suisanka/Project_Pulsar/exports/2026-10-24-reference-fit/README.zh-CN.md

# 已弃用：ReferenceFit 扩展试验

用户已明确要求原样采用提供的后壳，不按头模测试修改后壳。本目录中后移 40 mm 的旧七件套仅保留作历史记录，不作为当前方案。

当前数据与交付文件见 [后壳原样采用说明](../../docs/REFERENCE_REAR_EXACT.zh-CN.md)。
