suisanka/Project_Pulsar/variants/reference-fit/README.zh-CN.md

# 已弃用：ReferenceFit 扩展试验

`ProjectPulsar_ReferenceFit.blend` 保留为历史文件，不作为当前后壳方案。当前直接采用用户原始 STL，见 [后壳原样采用说明](../../docs/REFERENCE_REAR_EXACT.zh-CN.md)。
