suisanka/Project_Pulsar/docs/images/closure-v3-overview.png

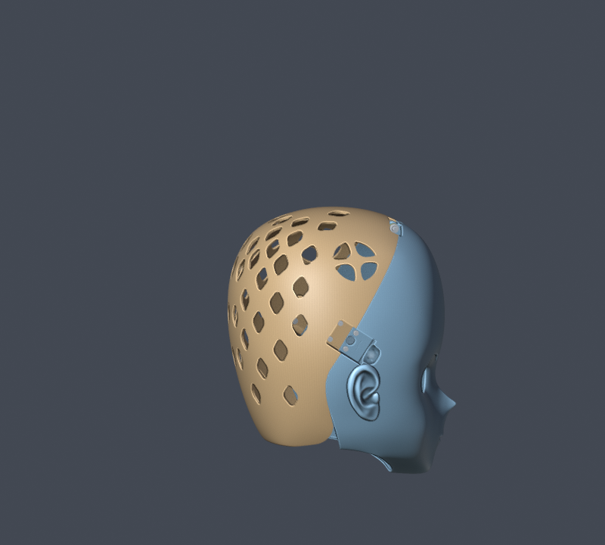
docs/images/closure-v3-overview.png
