suisanka/Project_Pulsar/docs/images/front-3mm-review_face.png

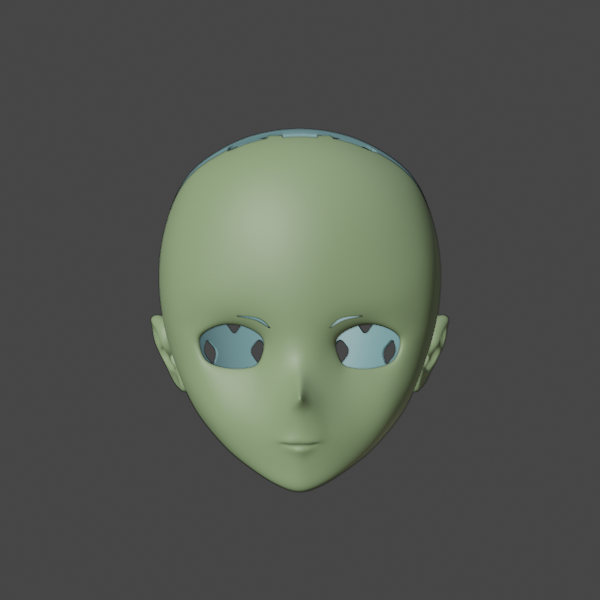
docs/images/front-3mm-review_face.png
