suisanka/Project_Pulsar/docs/images/front-3mm-review_face_quarter.png

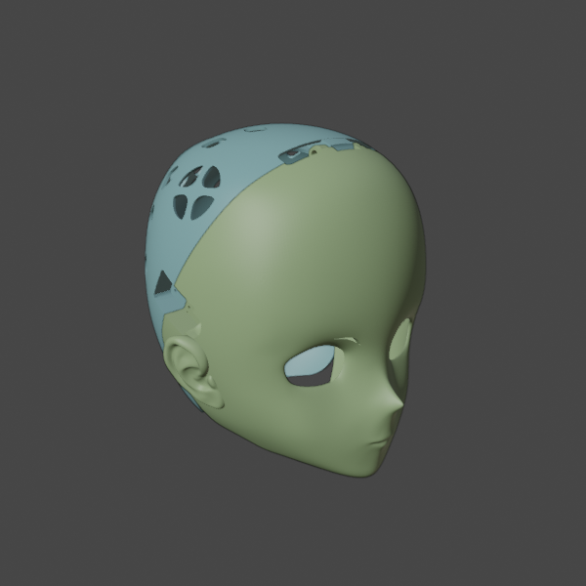
docs/images/front-3mm-review_face_quarter.png
