suisanka/Project_Pulsar/docs/images/front-3mm-review_right.png

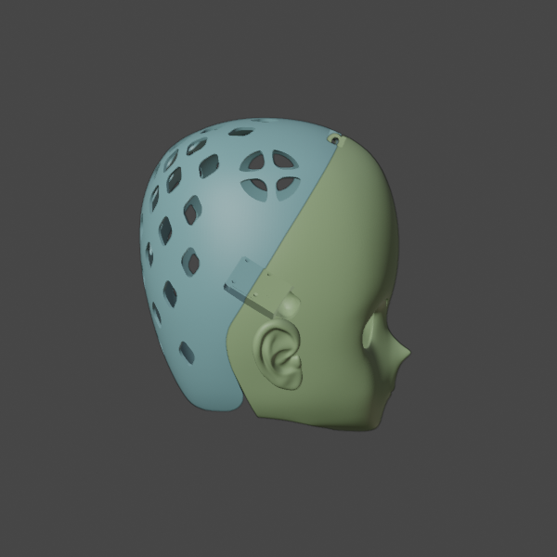
docs/images/front-3mm-review_right.png
