suisanka/Project_Pulsar/docs/images/front-3mm-review_top.png

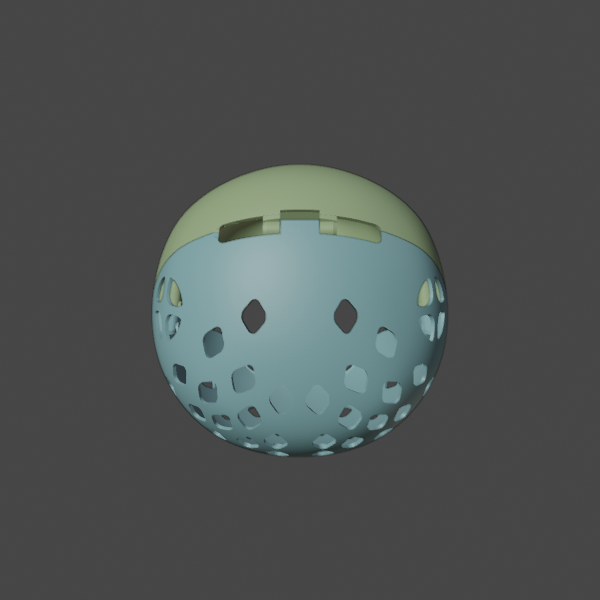
docs/images/front-3mm-review_top.png
