suisanka/Project_Pulsar/docs/images/front-3mm-wire.png

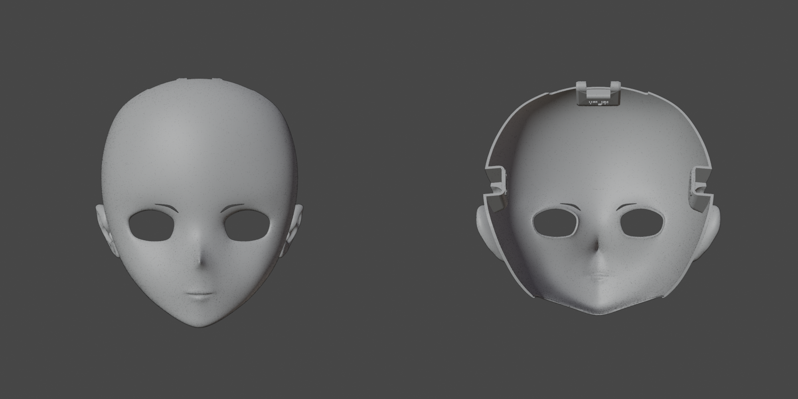
docs/images/front-3mm-wire.png
