suisanka/Project_Pulsar/docs/images/front-3mm-wire_inside.png

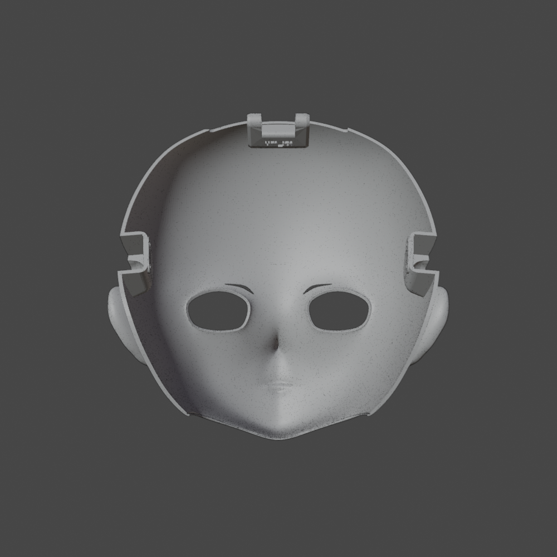
docs/images/front-3mm-wire_inside.png
