suisanka/Project_Pulsar/docs/images/head-horizontal-section.png

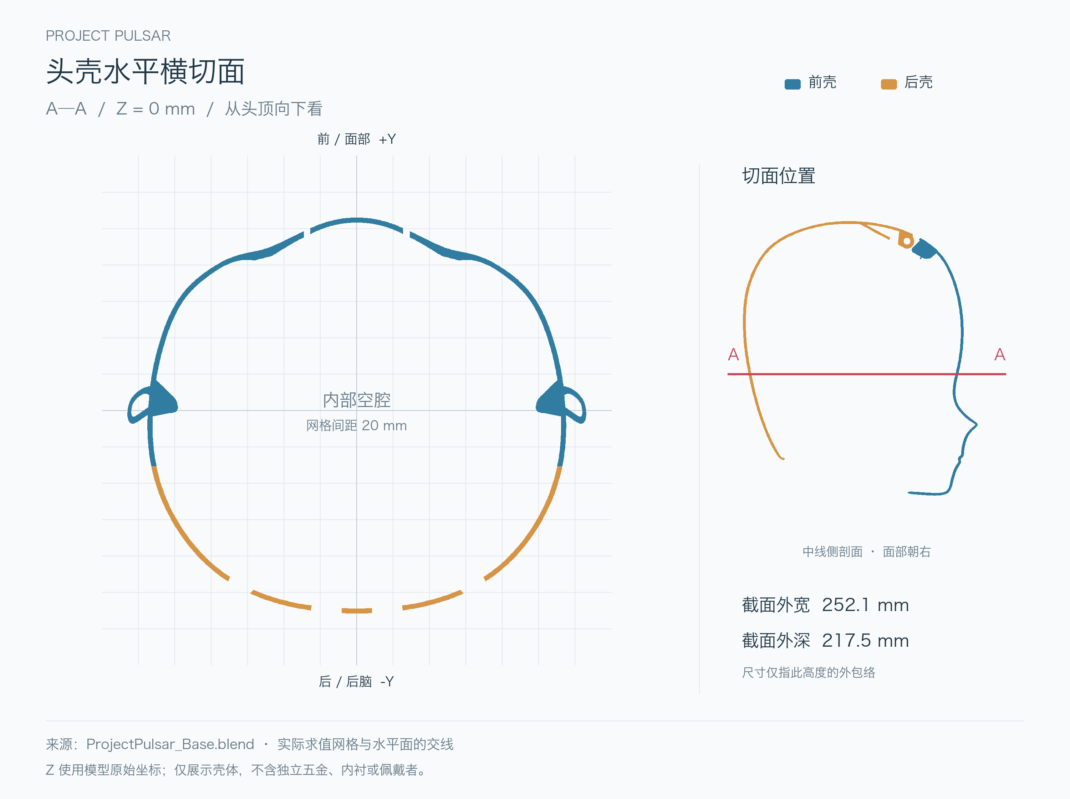
docs/images/head-horizontal-section.png
