suisanka/Project_Pulsar/docs/images/head-horizontal-sections-comparison.png

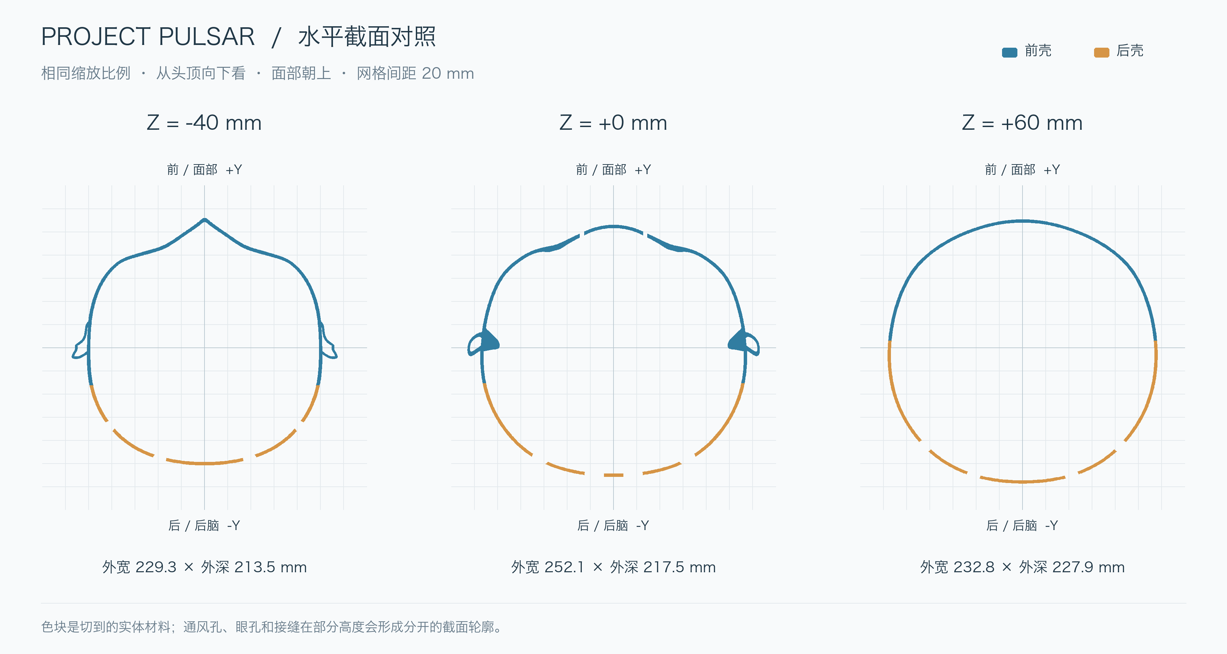
docs/images/head-horizontal-sections-comparison.png
