suisanka/Project_Pulsar/docs/images/head-vertical-section-dimensioned.png

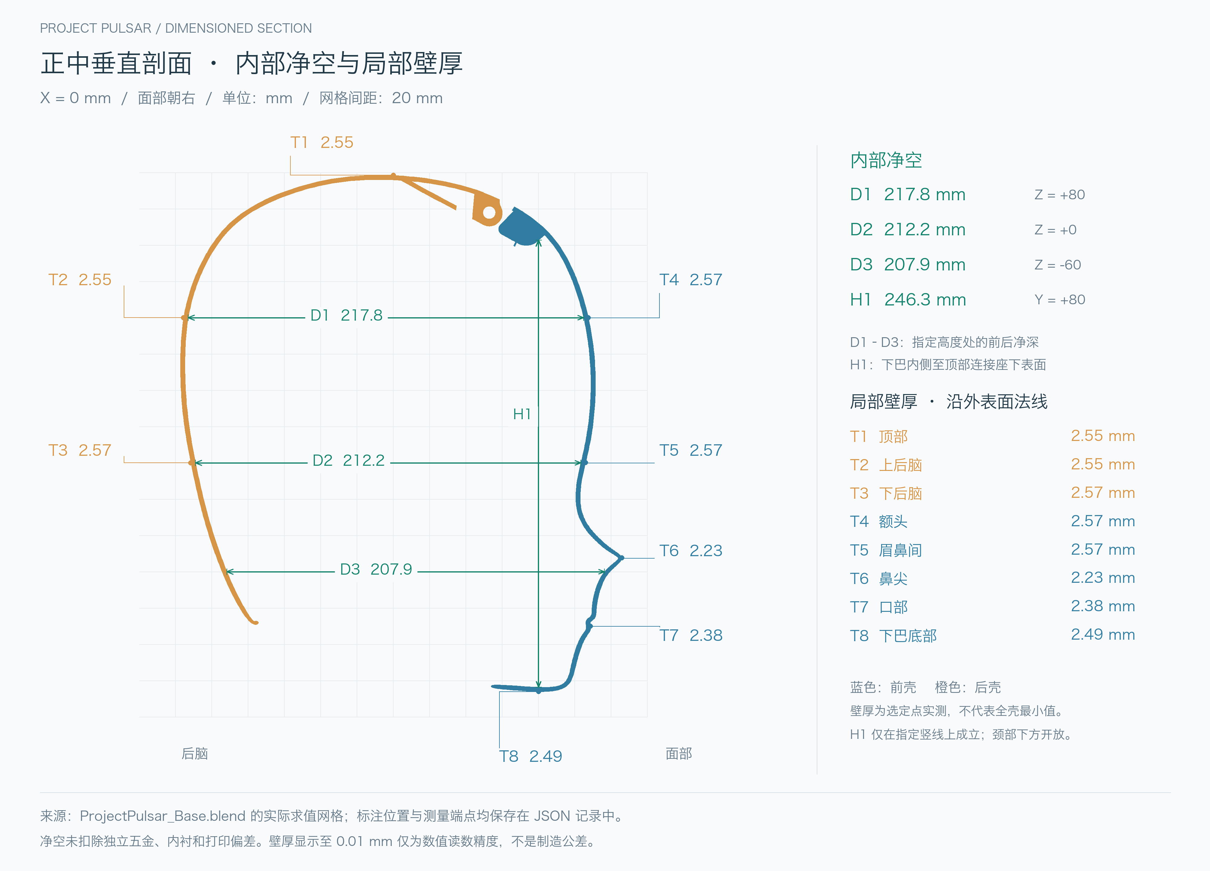
docs/images/head-vertical-section-dimensioned.png
