suisanka/Project_Pulsar/docs/images/head-vertical-section.png

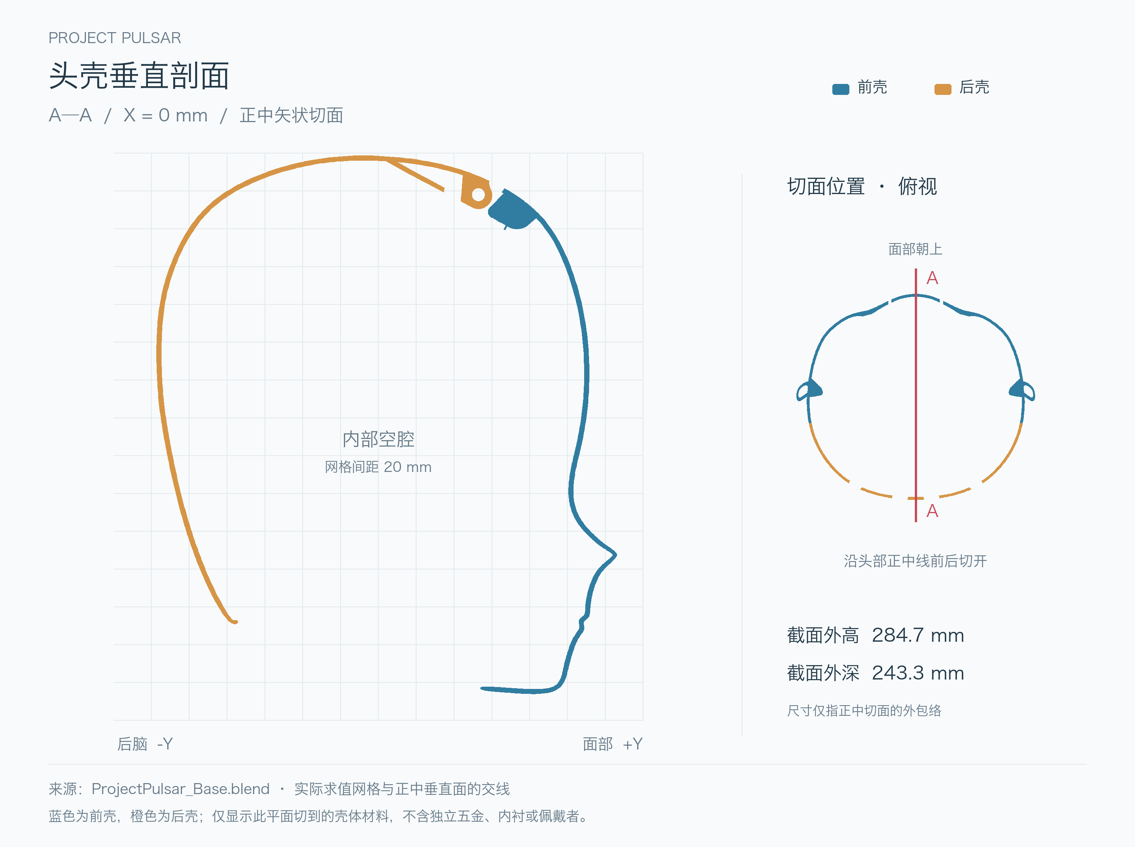
docs/images/head-vertical-section.png
