suisanka/Project_Pulsar/docs/images/headform-ellipse-cutaway.png

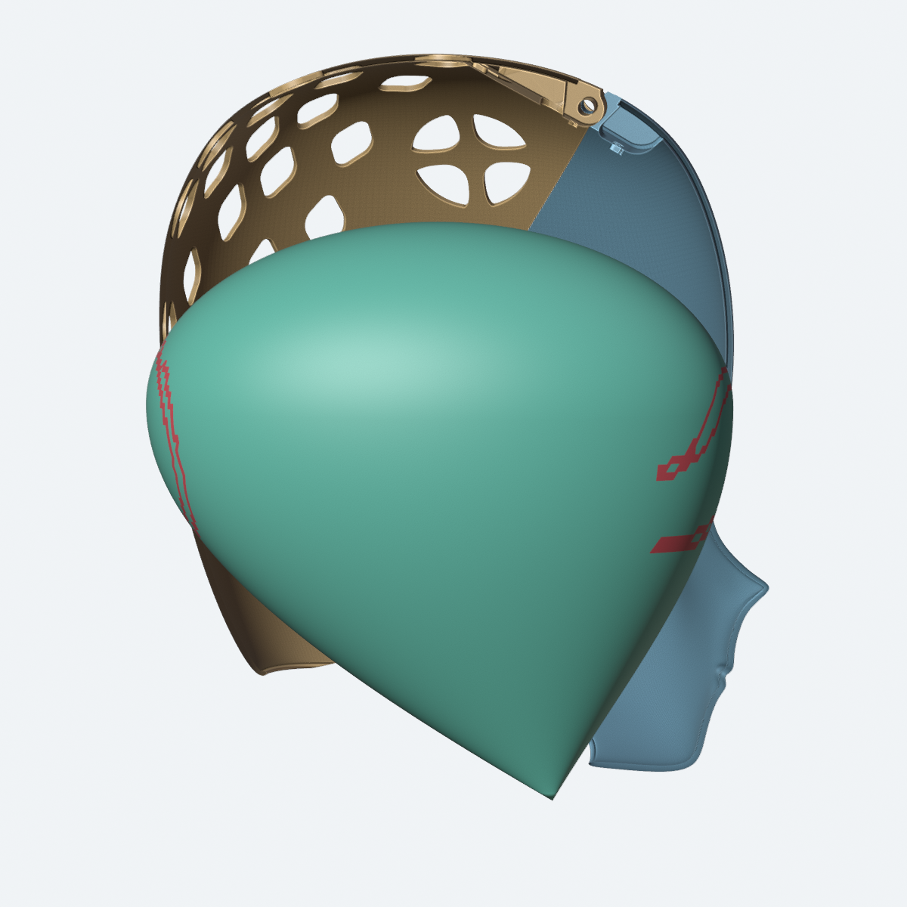
docs/images/headform-ellipse-cutaway.png
