suisanka/Project_Pulsar/docs/images/headform-ellipse-topology.png

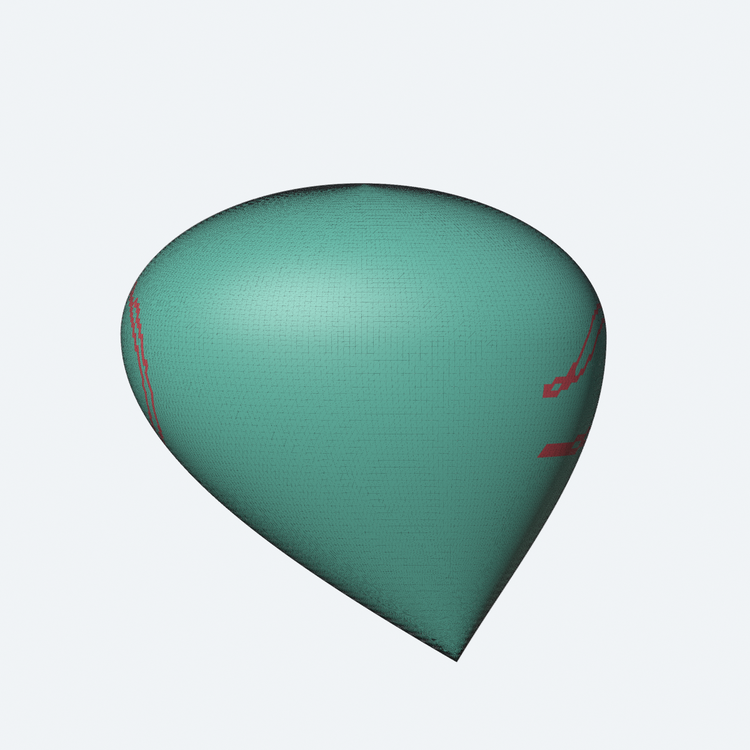
docs/images/headform-ellipse-topology.png
