suisanka/Project_Pulsar/docs/images/headform-fit-comparison.png

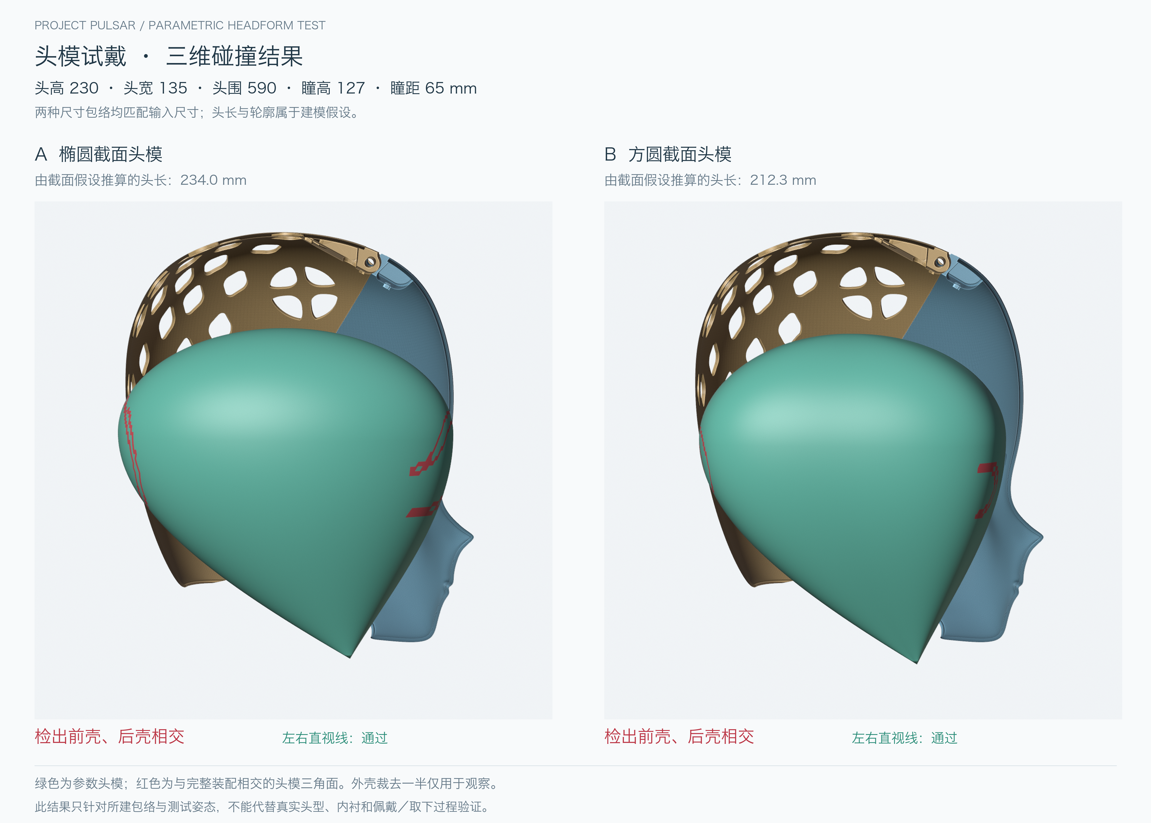
docs/images/headform-fit-comparison.png
