suisanka/Project_Pulsar/docs/images/headform-fit-sections.png

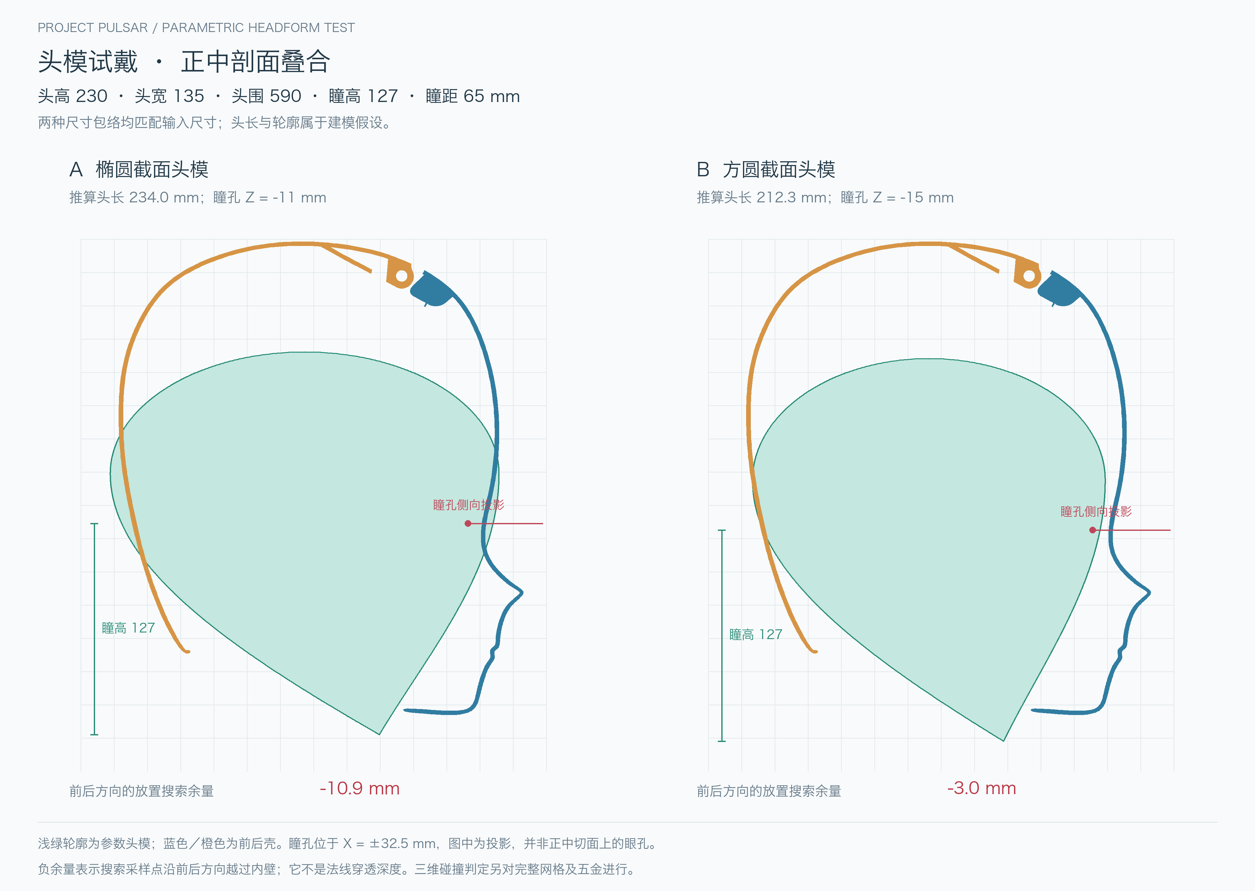
docs/images/headform-fit-sections.png
