suisanka/Project_Pulsar/docs/images/headform-rounded-topology.png

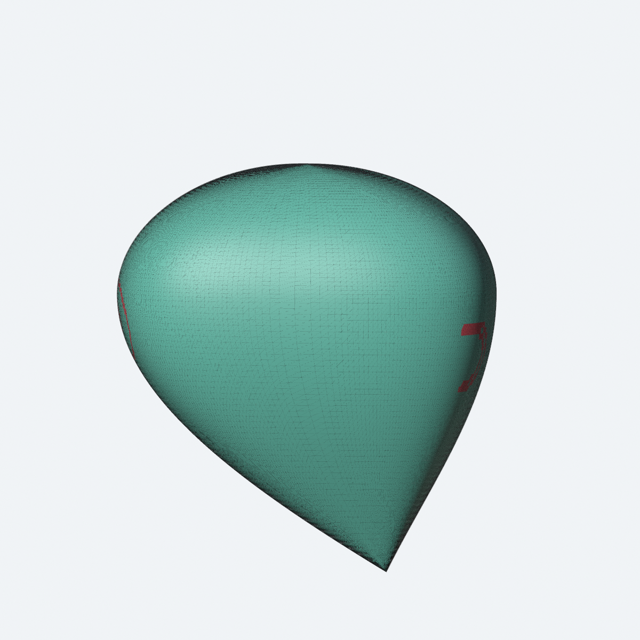
docs/images/headform-rounded-topology.png
