suisanka/Project_Pulsar/docs/images/hinge-v2-closed.png

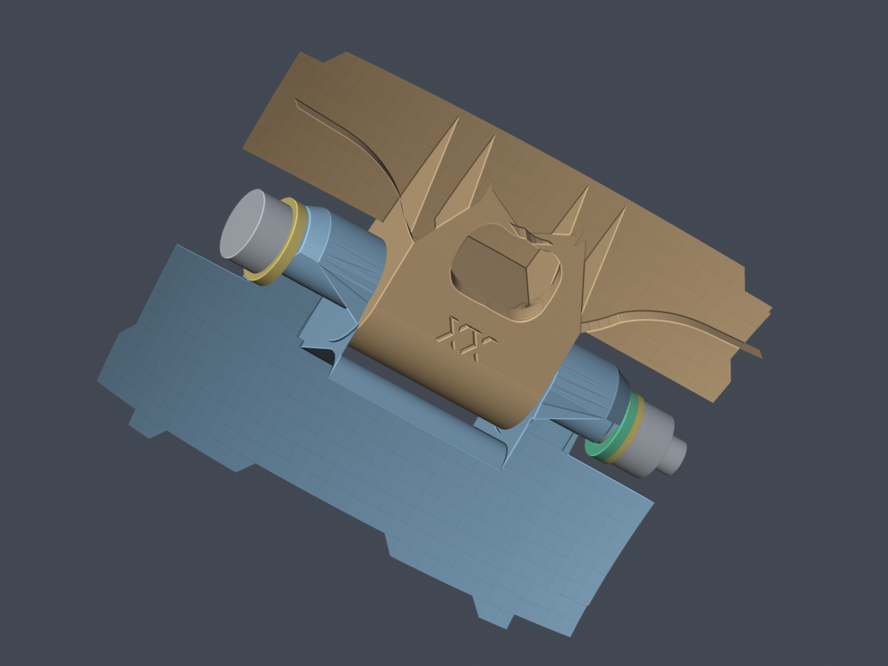
docs/images/hinge-v2-closed.png
