suisanka/Project_Pulsar/docs/images/hinge-v2-open-75.png

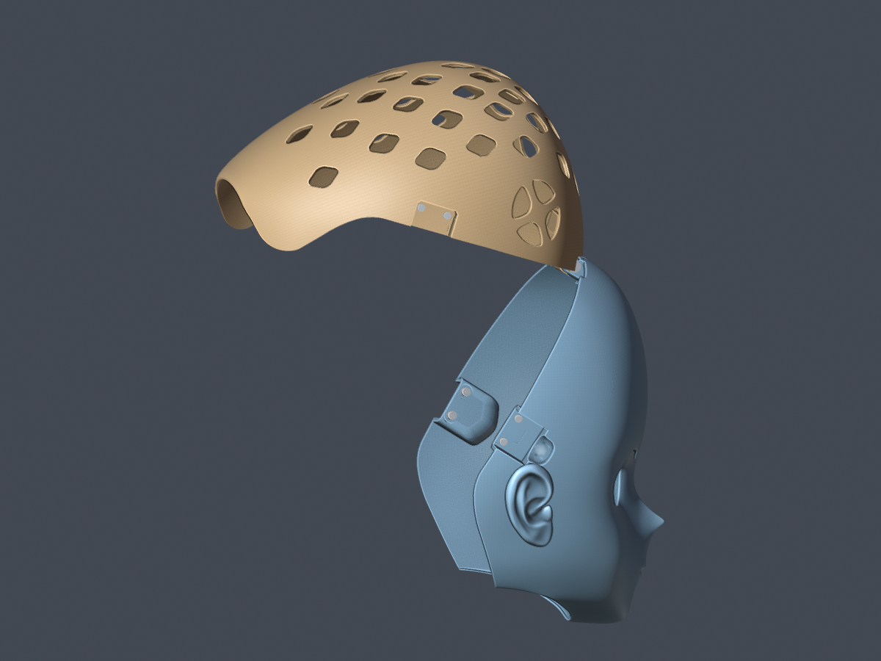
docs/images/hinge-v2-open-75.png
