suisanka/Project_Pulsar/docs/images/overview.png

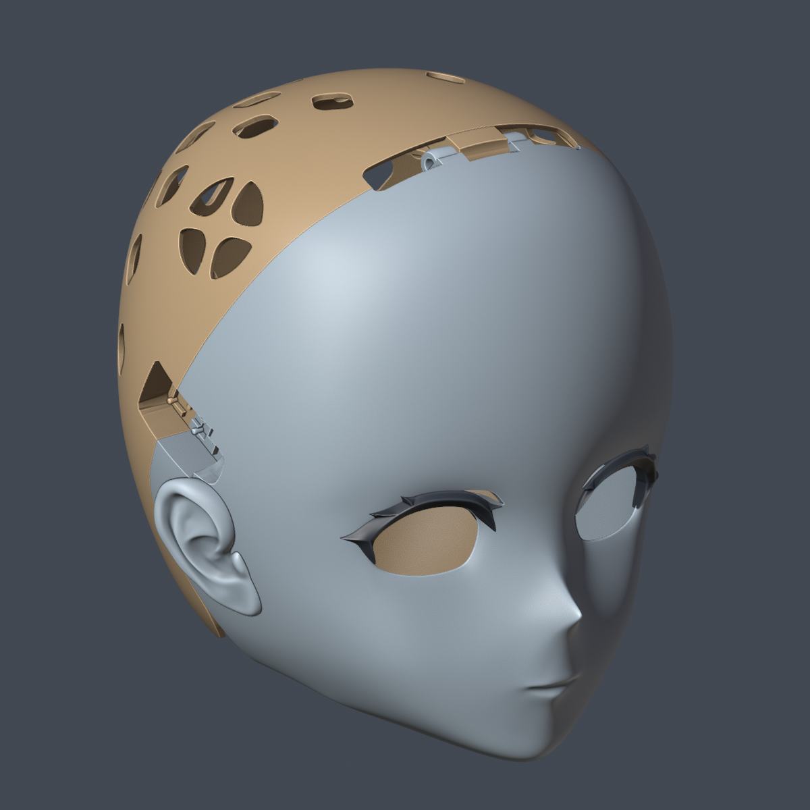
docs/images/overview.png
