suisanka/Project_Pulsar/docs/images/r-pin-profile.png

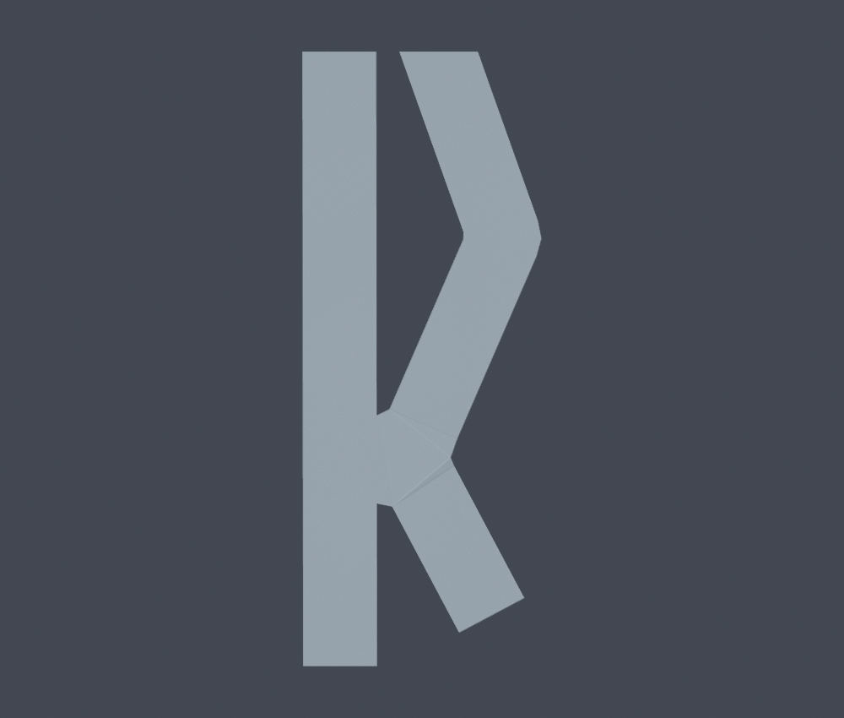
docs/images/r-pin-profile.png
