suisanka/Project_Pulsar/docs/images/reference-fit/ref-front-inside.png

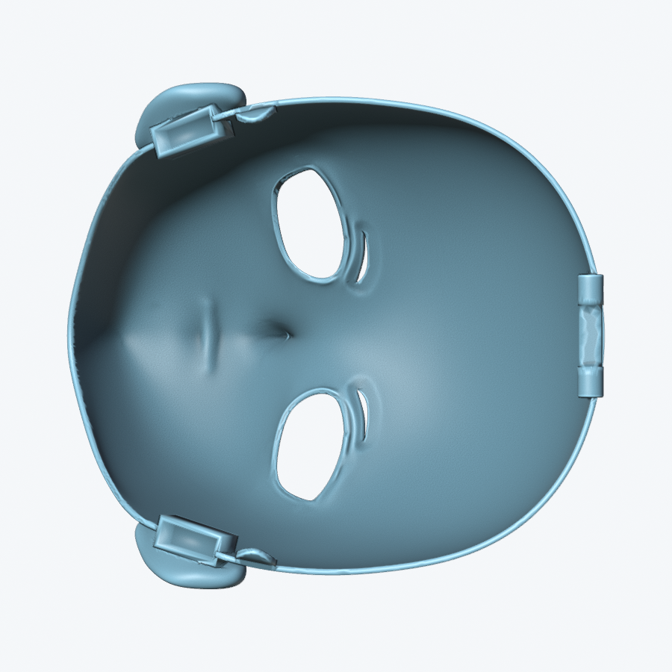
docs/images/reference-fit/ref-front-inside.png
