suisanka/Project_Pulsar/docs/images/reference-fit/ref-front-outside.png

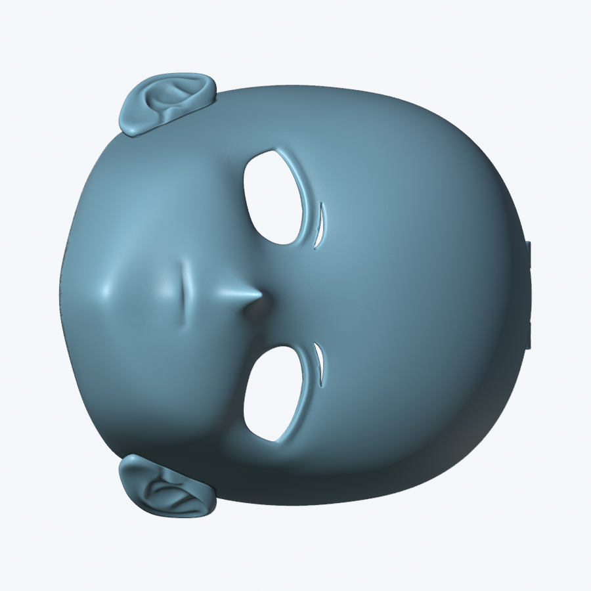
docs/images/reference-fit/ref-front-outside.png
