suisanka/Project_Pulsar/docs/images/reference-fit/ref-rear-inside.png

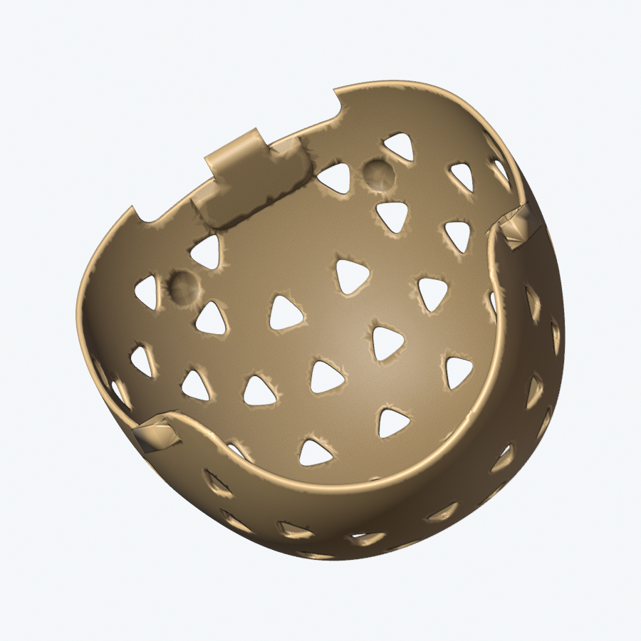
docs/images/reference-fit/ref-rear-inside.png
