suisanka/Project_Pulsar/docs/images/reference-fit/ref-rear-outside.png

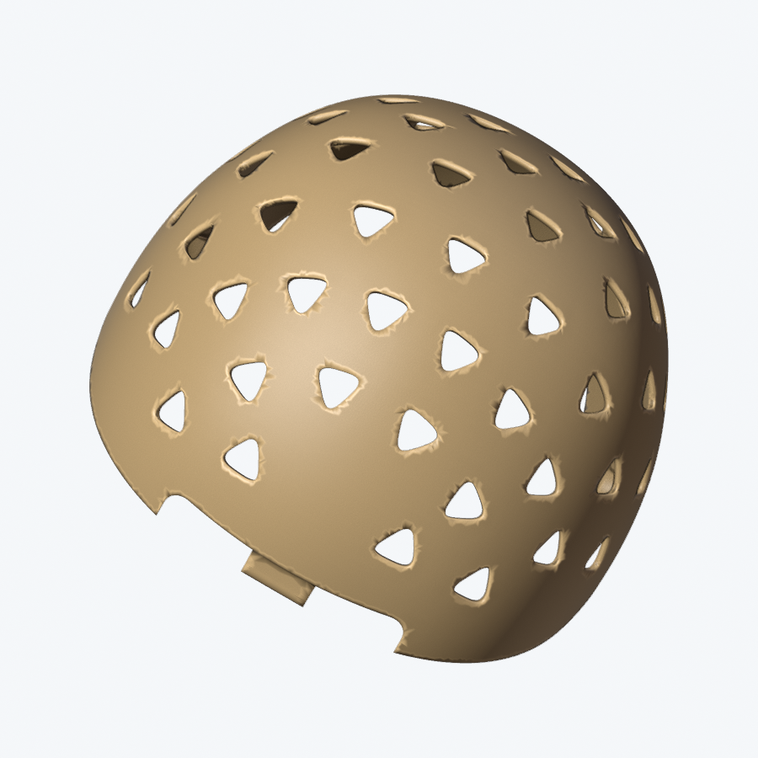
docs/images/reference-fit/ref-rear-outside.png
