suisanka/Project_Pulsar/docs/images/reference-fit/reference-fit-after-back.png

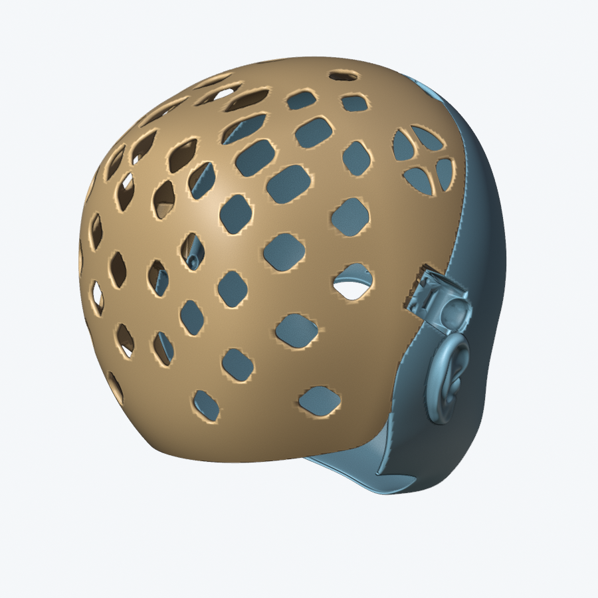
docs/images/reference-fit/reference-fit-after-back.png
