suisanka/Project_Pulsar/docs/images/reference-fit/reference-fit-after-cutaway.png

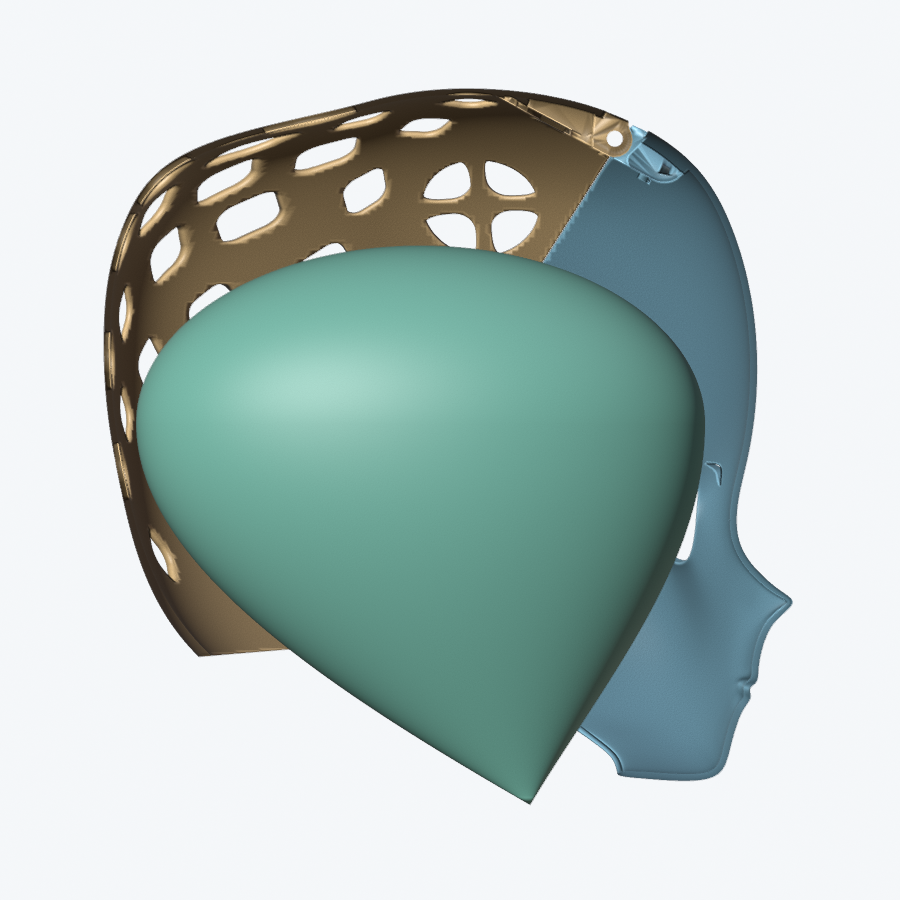
docs/images/reference-fit/reference-fit-after-cutaway.png
