suisanka/Project_Pulsar/docs/images/reference-fit/reference-fit-after-quarter.png

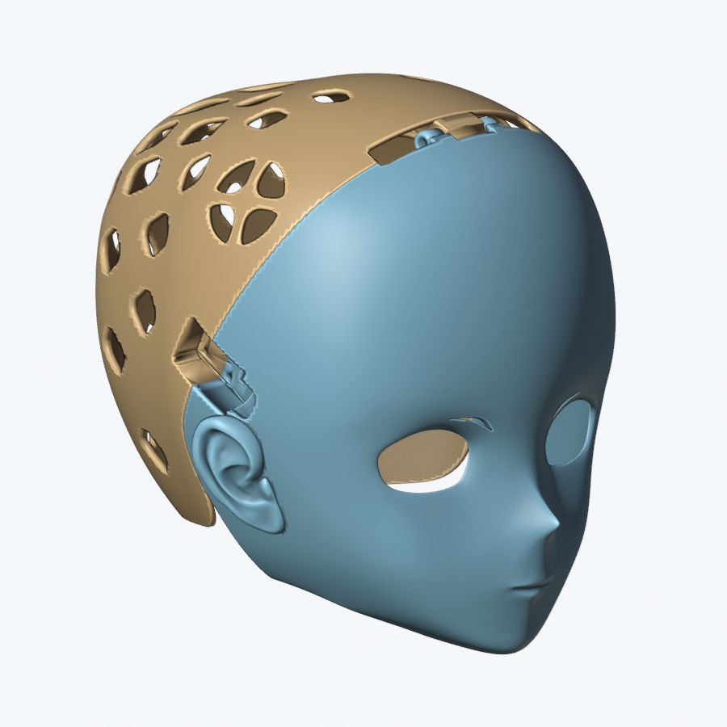
docs/images/reference-fit/reference-fit-after-quarter.png
