suisanka/Project_Pulsar/docs/images/reference-fit/reference-fit-after-side.png

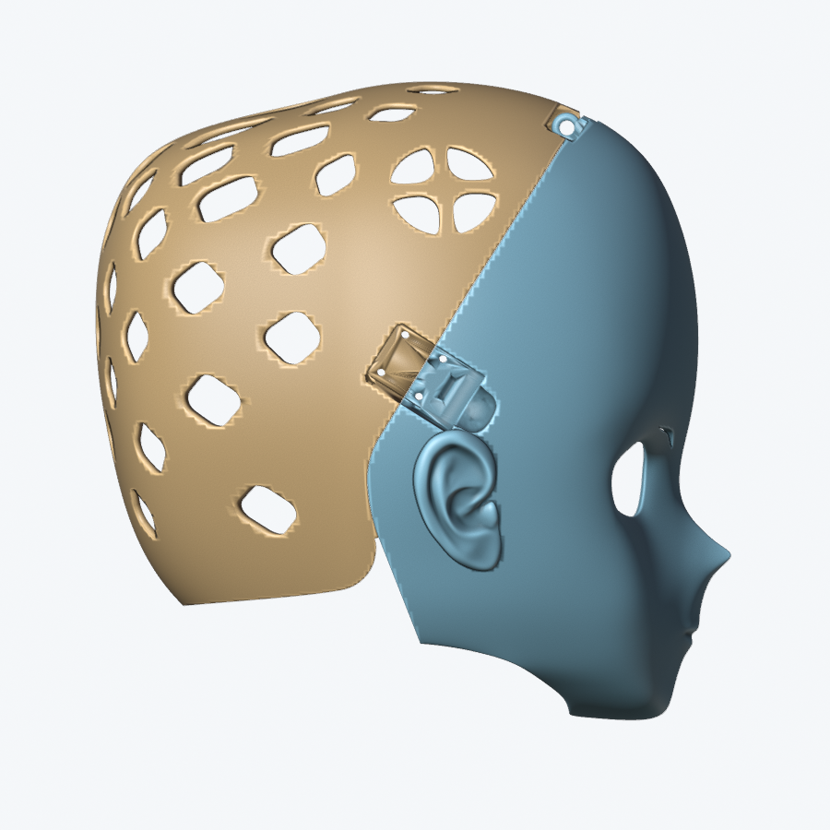
docs/images/reference-fit/reference-fit-after-side.png
