suisanka/Project_Pulsar/docs/images/reference-fit/reference-fit-before-side.png

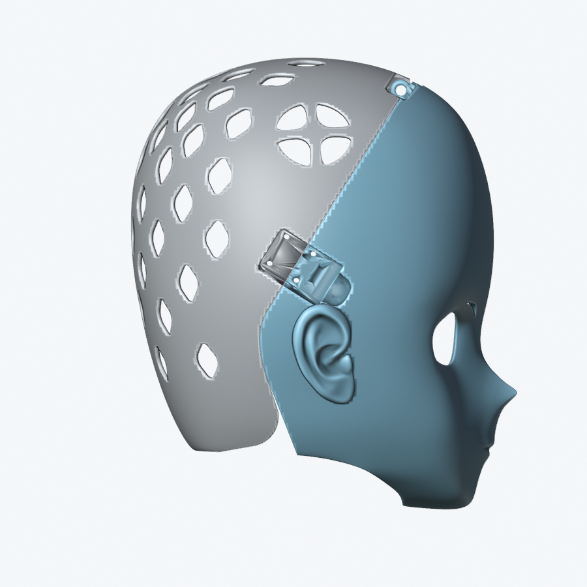
docs/images/reference-fit/reference-fit-before-side.png
