suisanka/Project_Pulsar/docs/images/reference-fit/reference-fit-rear-wire-inside.png

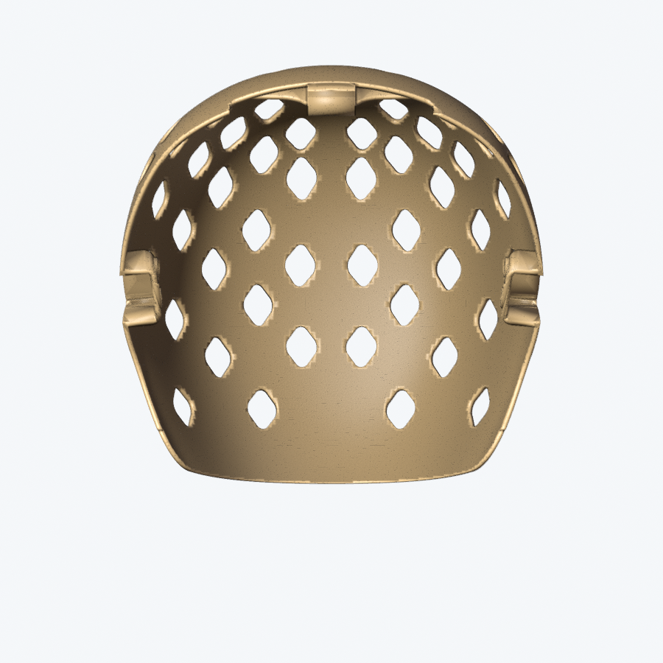
docs/images/reference-fit/reference-fit-rear-wire-inside.png
