suisanka/Project_Pulsar/docs/images/reference-fit/reference-fit-rear-wire.png

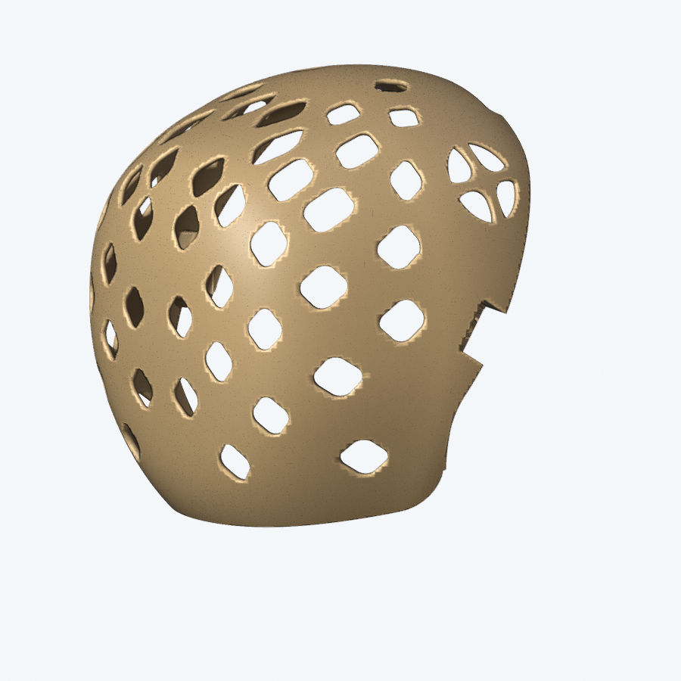
docs/images/reference-fit/reference-fit-rear-wire.png
