suisanka/Project_Pulsar/docs/images/reference-rear-exact/rear-exact-inside.png

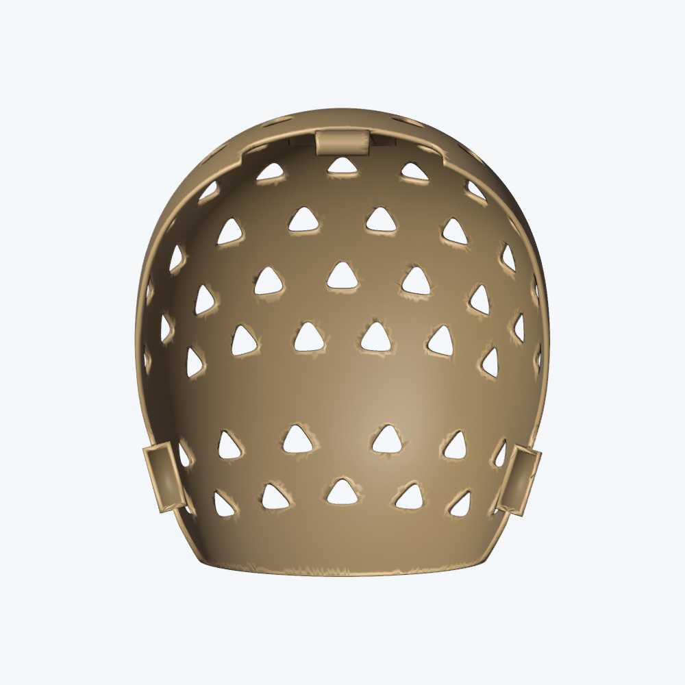
docs/images/reference-rear-exact/rear-exact-inside.png
