suisanka/Project_Pulsar/docs/images/reference-rear-rounded/rear-wire.png

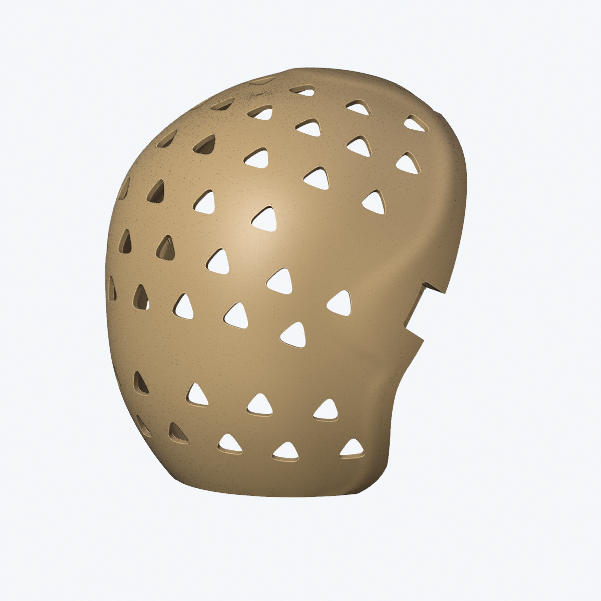
docs/images/reference-rear-rounded/rear-wire.png
