suisanka/Project_Pulsar/docs/images/side-latch-v3-inside.png

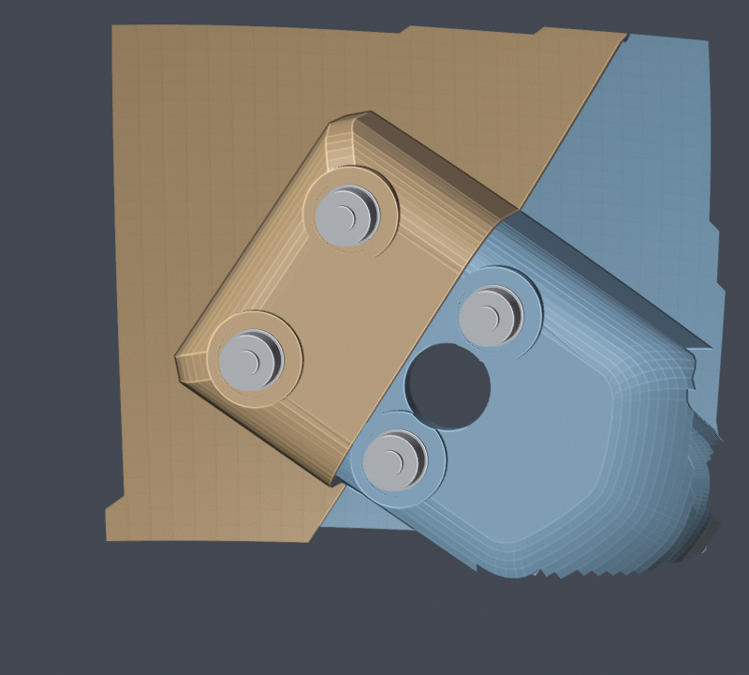
docs/images/side-latch-v3-inside.png
