suisanka/Project_Pulsar/docs/images/side-latch-v3-outside.png

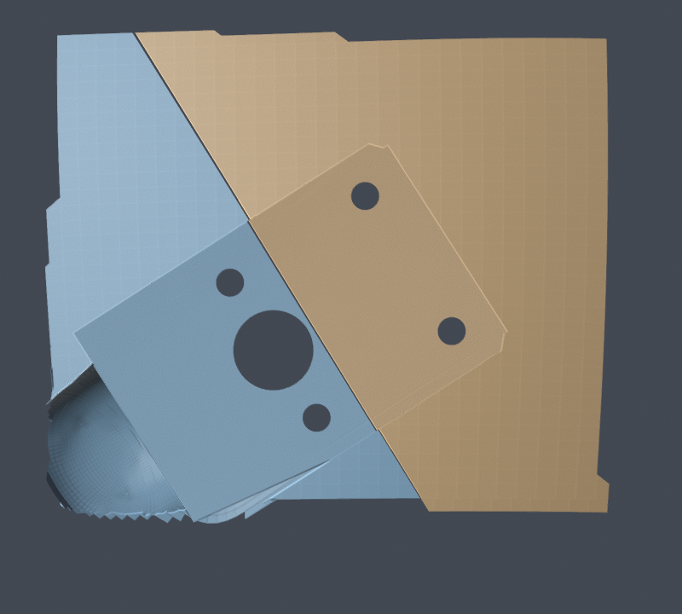
docs/images/side-latch-v3-outside.png
