suisanka/Project_Pulsar/docs/images/side-lock-dimensions.png

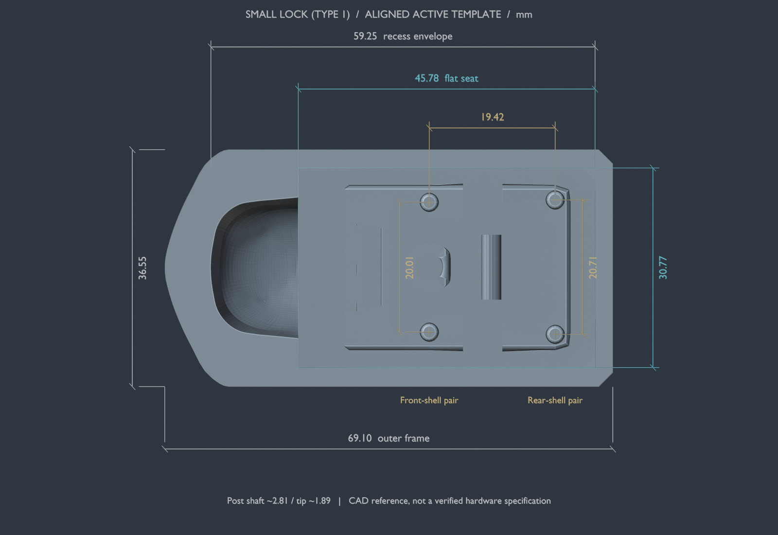
docs/images/side-lock-dimensions.png
