suisanka/Project_Pulsar/docs/images/side-lock-seat.png

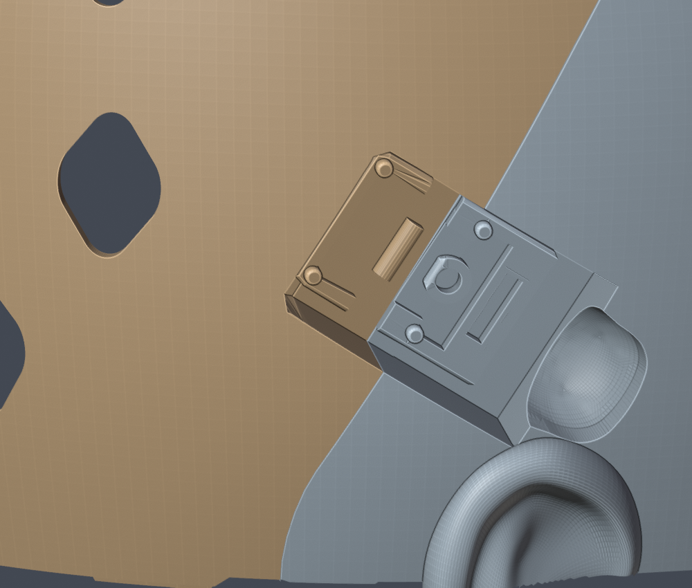
docs/images/side-lock-seat.png
