suisanka/Project_Pulsar/docs/images/top-hinge.png

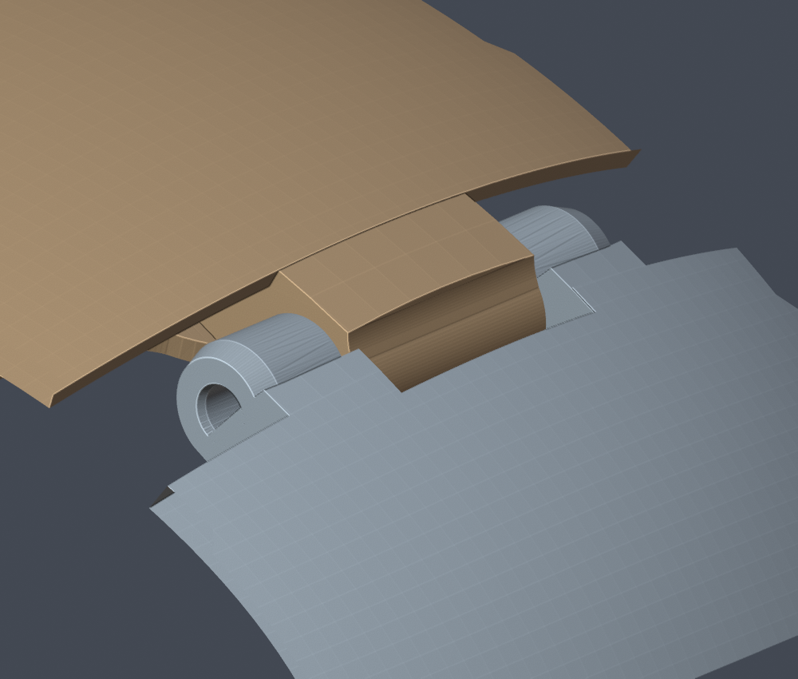
docs/images/top-hinge.png
