suisanka/Project_Pulsar/docs/ProjectPulsar_BOM_Closure_v4.csv

序号 | 类别 | 部位/用途 | 物料名称 | 规格（尺寸单位：mm） | 每套数量 | 单位 | 材料 | STL文件 | 备注
1 | 打印 | 壳体 | 前壳 | Closure v4；侧锁中心补实 | 1 | 件 | PLA | ProjectPulsar_Front_Closure_v4.stl | 拓竹 H2S，0.4 mm 喷嘴；耗材重量以切片为准
2 | 打印 | 壳体 | 后壳 | Closure v4 | 1 | 件 | PLA | ProjectPulsar_Rear_Closure_v4.stl | 拓竹 H2S，0.4 mm 喷嘴；与 v4 前壳配套
3 | 打印 | 顶部转轴 | 轴向垫套 | 内径 Ø6.6 × 外径 Ø10 × 厚 1.4 | 1 | 件 | PLA | ProjectPulsar_Hinge_Spacer_1p4.stl | 已平放；安装在螺母侧前壳耳面与 M5 平垫圈之间
4 | 采购 | 顶部转轴 | 金属肩轴螺钉 | 光轴 Ø6 × 55；尾牙 M5 × 0.8，长 9.5；头 Ø10 × 高 4.5 | 1 | 件 | 金属 |  | 尺寸实例 Ganter ISO 7379-6-M5-55；55 指光轴长度；明确选 Ø6，不选 Ø6.5
5 | 采购 | 顶部轴头侧 | M6 平垫圈 | 内径 6.4 × 外径 12 × 厚 1.6 | 1 | 件 | 金属 |  | 先套在肩轴上，置于轴头与前壳耳面之间
6 | 采购 | 顶部螺母侧 | M5 平垫圈 | 内径 5.3 × 外径 10 × 厚 1.0 | 1 | 件 | 金属 |  | 抵住 Ø6 金属轴肩；不要与轴头侧 M6 垫圈混用
7 | 采购 | 顶部螺母侧 | M5 尼龙圈防松螺母 | DIN 985；M5 × 0.8；对边 8，高 5 | 1 | 件 | 金属及尼龙圈 |  | 与 M5 平垫圈配合止退
8 | 采购 | 左右侧锁 | 带钥匙锁四方搭扣 | 40 × 27 × 12.5；孔距 20 × 20；4 孔 Ø3.5；底板厚 0.5 | 2 | 只 | 金属 |  | 每侧 1 只，含配对扣片；钥匙随锁配套；v4 中心无让位孔，先用试件确认实物贴合
9 | 采购 | 左右侧锁 | M3 低圆头螺丝 | ISO 7380-1；M3 × 10，螺距 0.5；头 Ø5.7 × 高 1.65 | 8 | 件 | 金属 |  | 每侧 4 件；选无额外法兰款；配 2 mm 内六角
10 | 采购 | 左右侧锁背面 | M3 平垫圈 | 内径 3.2 × 外径 7 × 厚 0.5 | 8 | 件 | 金属 |  | 每侧 4 件；置于塑料承压区与防松螺母之间
11 | 采购 | 左右侧锁背面 | M3 尼龙圈防松螺母 | DIN 985；M3 × 0.5；对边 5.5，高 4 | 8 | 件 | 金属及尼龙圈 |  | 每侧 4 件；名义装配后螺纹露出约 1 mm
12 | 试打 | 顶部铰链 | 前壳局部试件 | 与 v4 整壳相同配合几何 | 1 | 件 | PLA | ProjectPulsar_Hinge_Test_Front.stl | 先行装配试打；不计入成品壳体
13 | 试打 | 顶部铰链 | 后壳局部试件 | 与 v4 整壳相同配合几何 | 1 | 件 | PLA | ProjectPulsar_Hinge_Test_Rear.stl | 与顶部前壳试件配对
14 | 试打 | 左侧搭扣 | 前壳局部试件 | 20 × 20 孔距；中心无让位孔 | 1 | 件 | PLA | ProjectPulsar_SideLatch_Test_Front_L.stl | 使用 v4 导出目录中的文件；两侧孔型镜像相同
15 | 试打 | 左侧搭扣 | 后壳局部试件 | 20 × 20 孔距 | 1 | 件 | PLA | ProjectPulsar_SideLatch_Test_Rear_L.stl | 使用 v4 导出目录中的文件；与侧锁前壳试件配对
16 | 工具 | 顶部肩轴安装 | 内六角扳手 | 3 mm | 1 | 把 |  |  | 可重复使用，不装入成品
17 | 工具 | 侧锁螺丝安装 | 内六角扳手 | 2 mm | 1 | 把 |  |  | 可重复使用，不装入成品
18 | 工具 | 顶部螺母安装 | 小套筒 | 8 mm；外径 ≤12 mm | 1 | 个 |  |  | 可重复使用；匹配 M5 螺母
19 | 工具 | 侧锁螺母安装 | 薄壁套筒 | 5.5 mm；外径 ≤8 mm | 1 | 个 |  |  | 可重复使用；匹配 M3 螺母
