suisanka/Project_Pulsar/assets/reference/user-rear-2026-10-24/后半头壳-全头.stl

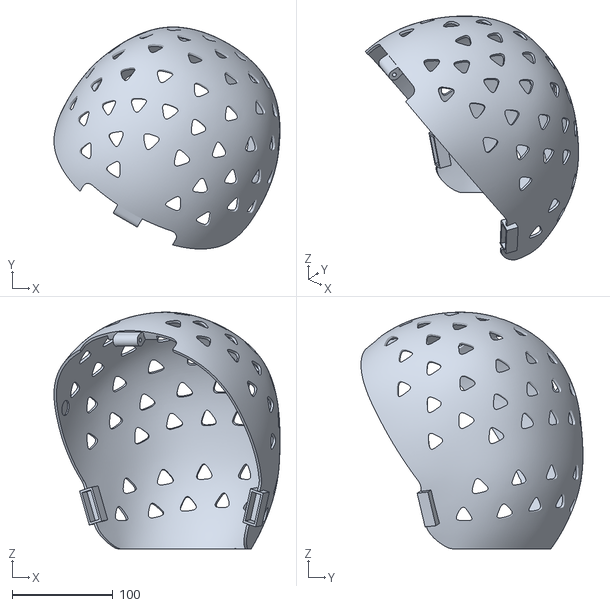
[picture p48: CAD file, 2026-10-24]
assets/reference/user-rear-2026-10-24/后半头壳-全头.stl
224.3 x 220.3 x 234.9
