suisanka/Project_Pulsar/(list of files, cad)

Other CAD files:
ProjectPulsar_Base.blend
studies/headform-fit-2026-10-22/ProjectPulsar_HeadformFit_230-135-590.blend
variants/front-3mm/ProjectPulsar_Front3mm.blend
variants/reference-fit/ProjectPulsar_ReferenceFit.blend
variants/reference-rear-exact/ProjectPulsar_ReferenceRearExact.blend
variants/reference-rear-rounded/ProjectPulsar_ReferenceRearRounded.blend
