suisanka/Project_Pulsar/Fix_History.md

# Fix History

这份文档记录了对上游 [vuicoo/plumKigurumi-](https://github.com/vuicoo/plumKigurumi-) 中 `plumAlpha0.2fix.blend`（2024-01-22）的全部修改，作为 GNU GPL v3 第 5 条要求的修改声明。

- 修改日期：2026 年 9 月至 10 月
- 工具：第一至四轮使用 Blender 5.1.2；第五轮使用 Blender 5.2.2 LTS

## 2026-10-24：按用户更正，后壳直接采用原始 STL

用户明确要求“不要按头模测试，你照抄我给你的后壳数据”。据此将此前 ReferenceFit 40 mm 扩展方案标为弃用，当前后壳改为提供的 `后半头壳-全头.stl` 原始网格。

- 后壳源文件归档到 `assets/reference/user-rear-2026-10-24/`，试验用 STL 直接按字节复制，不重建、简化、扩孔、加厚、变形或重新设计通风孔／卡扣。
- 新增独立 `variants/reference-rear-exact/ProjectPulsar_ReferenceRearExact.blend`，使用毫米场景保存原生 STL 顶点，重新打开后逐三角面核对顶点坐标与绕序。原方案保留为明确命名的历史编辑场景。
- 另设仅旋转／平移的接口对照场景；其摆放不改变后壳局部数据，不代表与 Front3mm 或 Closure v4 五金已匹配。
- 本轮不创建、不拟合、不验证头模。后壳形状唯一基准是用户提供的数据，文件哈希、一致性核对及原始网格检查见[原样采用说明](docs/REFERENCE_REAR_EXACT.zh-CN.md)。

## 2026-10-24：参考头壳的后脑空间与下缘分件修订

根据用户提供的 `前半头壳.stl` 与 `后半头壳-全头.stl`，按确认的佩戴空间优先方向，从 Front3mm 生成独立 `variants/reference-fit/ProjectPulsar_ReferenceFit.blend`，Base 和 Front3mm 源文件保留。

- 前壳及独立五金求值网格保持一致。后壳使用沿 Y 的单调平滑扩展：Y ≥ -45 mm 固定，Y ≤ -110 mm 向后平移 40 mm；中间五次插值，不统一缩放孔径或五金。
- 后壳圆角位置由 0.037 改为 0.055，扩大下缘避让；主分缝基准 0.78、顶部肩轴与两侧搭扣规格保持原值。
- 新布尔输出的一处极小三角面，在指定半径 0.2 mm 区域内以 0.04 mm 阈值仅合并连接边，移除 2 个顶点与 4 个三角面；后壳仍为一个封闭材料部件。
- 新增构建、独立包络／壁厚验证、实际网格渲染与配图脚本。顶部验证增加显式 `--rear-round`，默认仍为原版 0.037；本版使用 0.055 并写入验证记录，不取消已保存参数与预期参数必须一致的检查。
- 数字头模采用仓库既有两种尺寸包络，新增 7 mm 距离下界认证，以及后壳保持 75° 时头模直线戴入的连续扫掠凸包检查。该结果不等同于真人扫描、颈肩通行、内衬实装或舒适度验收。
- 保留通用 QA 的一处旧版铰链近共面提示，并逐三角面验证与基线完全一致；不宣称通用全壳 QA 无提示。全部新增错误仍阻止独立验证通过。

设计参数、参考文件 SHA-256、同尺度对照、体积增加、最终检查记录及七份 STL 导出路径见 [ReferenceFit 修订说明](docs/REFERENCE_FIT.zh-CN.md)。

## 2026-10-21：取消侧锁中心让位孔，补实安装座

按用户反馈，取消上一版两侧 Ø10 mm 锁芯尾部让位孔。该孔原是没有厂家实测尺寸的设计预留，本轮不再保留。

- 两侧安装座中心补实，前壳两颗螺丝之间增加 12 × 16 mm、厚 4 mm 的实体连接区，与原安装座合并；保留每侧四个 Ø3.5 mm 螺丝通孔及 20 × 20 mm 孔距。
- M3 × 10 螺丝、垫圈和防松螺母的装配规格继续使用，guide 中物料表对应的整壳文件名更新为 v4。
- 侧锁检查增加原 Ø10 mm 覆盖范围的每侧 81 点实体与厚度测量。实测两侧约 4.00–4.05 mm 厚、均无缺失点；旧带孔模型作为反例，被同一检查明确拒绝。
- 七份 STL 重新导出到 `exports/2026-10-21-closure-v4/`，更新实际网格配图、开合预览和匹配新工程 SHA 的验证记录。此前 v3 目录保留为历史文件。

当前 Base 的标准拓扑／导出回归 **61/61 通过**；开合扫描 **321/321 姿态通过**；七份 STL 均导出回读通过。

本轮是几何补实和数字装配验证；没有进行 PLA 承载、疲劳或实物五金试装，不将厚度检查表述为材料强度验收。当前记录见 `docs/side-latch-validation-2026-10-21.json`、`docs/side-latch-solid-negative-control-2026-10-21.json`、`docs/top-hinge-validation-2026-10-21.json`、`docs/top-hinge-regression-2026-10-21.json` 和 `docs/top-hinge-stl-manifest-2026-10-21.json`。

继续支持从 `0fa5c75` 的 Base 依次运行顶部、侧锁改造脚本重放；当前侧锁脚本直接构建无中心孔的实体连接区，并保存侧锁修订号 2。

## 2026-10-21：顶部肩轴与两侧螺丝固定搭扣（v3 历史版本）

本轮从 `0fa5c75` 的 Base 改造，当时交付为 `exports/2026-10-21-closure-v3/`，现由上节 v4 取代。保持黑色睫毛／眼线隐藏，保留眉形开孔。

- 顶部采用明确的采购规格：Ø6 × 55 mm 光轴、M5 尾牙的肩轴螺钉，M6／M5 金属平垫圈、1.4 mm 打印垫套和 M5 尼龙圈防松螺母。旧 `r插销` 隐藏并标为历史未使用件。
- 前后轴孔统一为 Ø6.6 mm；前壳内侧耳面让位至轴心 X±14 mm，实测每侧轴向间隙约 0.728 mm。轴端栈保留约 1.02 mm 轴向余量，M5 垫圈抵住金属轴肩，避免用螺母夹死塑料耳轴。
- 新增左侧轴头／M6 垫圈的直线插入通道。原始就位检测没有暴露插入途中冠部擦碰；本轮验证整个插入扫掠体后补足了让位。
- 原后壳刚性侧插舌在起始开合约 0–4° 时与前壳相交，已从最终并集断开；保留源对象与节点，侧锁安装座继续使用。
- 两侧安装座改为用户指定的 40 × 27 × 12.5 mm 带锁搭扣，20 × 20 mm 孔距、Ø3.5 mm 金属孔、0.5 mm 底板。去掉旧实心定位柱，增加 8 个 Ø3.5 通孔、Ø11／厚 4 mm 承压区、背面 Ø8.6 mm 五金／套筒空间与 Ø10 mm 锁芯尾部让位孔。
- 侧锁采购 8 套 ISO 7380-1 M3 × 10 低圆头螺丝、3.2 × 7 × 0.5 mm 金属平垫圈、DIN 985 M3 防松螺母。螺纹在名义夹持栈外余约 1 mm。
- 大圆角配置的布尔结果出现 STL float32 量化后重合的顶点；在后壳现有清理／异常重建判定之前增加 0.0001 mm 的全域近重合顶点合并。默认两壳不触发 SDF 重建。
- 增加可重放改造、装配扫描、侧锁孔位测量、受验证记录保护的导出与图示脚本。导出器同时核对运动验证、侧锁验证与源工程 SHA，防止把旧验证记录用于新模型。
- 交付两份整壳、一份垫套、两份顶部试件和两份侧锁试件，共七份 STL；全部回读检查。五金参考包络和旧 R 插销不导出为打印件。guide 第 4.5 节提供整套物料表，第 7.5 节提供复现命令。

最终合并工程的标准拓扑／导出回归 **61/61 通过**；七个交付 STL 均回读通过。当前数字证据见 `docs/top-hinge-validation-2026-10-21.json`、`docs/side-latch-validation-2026-10-21.json`、`docs/top-hinge-regression-2026-10-21.json` 和 `docs/top-hinge-stl-manifest-2026-10-21.json`。完整网格与五金外形在 0–80° 每 0.25° 扫描，共 321 个姿态；0°、40°、75°、80°另做实体求交。检查含完整包含情况、插入／工具通道，以及过粗轴、反向开合与止退件逃逸的应碰撞对照。八个侧锁孔另逐孔实测通透、截面、孔距和承压厚度。

这是默认配置的离散数字装配检查，不是连续碰撞证明、实物装配、切片、扭矩、疲劳或承载试验。商品锁盖的活动机构与锁芯尾部完整尺寸未提供 CAD，实物细节仍应使用局部试件确认。常用开角为 0–75°，80°不是机械硬限位。参数矩阵的其他配置仅进行拓扑／导出回归，不沿用默认配置的机械验收。

重放时先从 `0fa5c75` 取出 Base，对临时副本运行 `tools/repair_top_hinge.py`，再以其输出运行 `tools/repair_side_latches.py`；两个脚本都要求明确的 `--output` 与 `--receipt`，并拒绝重复应用。保存后须重新运行验证并使用匹配该新文件 SHA 的记录导出。

---

## 修复后的参数

| 项目 | 修复后 | 原作者演示视频 |
|---|---|---|
| 头壳（已应用缩放） | 23.7 × 24.3 × 28.5 cm | 23.7 × 24.3 × 28.5 cm |
| 前壳 | 25.29 × 16.22 × 27.09 cm（第四轮铰链关节缩径前为 27.14） | 25.3 × 16.2 × 27.2 cm |
| 后壳 | 23.66 × 17.74 × 24.85 cm | 视频未展示 |
| 锁类型 / 前后基准值 / 锁深度位移 | 1 / 0.780 / 1.100 | 同左 |
| 后壳圆角位置 | 0.037（第四轮重新定义，等同原来的 0.017） | 同左 |
| 后壳通风孔 | 58 个，全部贯穿，最小余量 2.7 mm | — |
| 附件突出头壳外表面 | ≤ 0.02 mm（修复前最大 2.5 mm） | — |
| 开启布尔后前后壳重算 | 第四轮记录约 2.3 秒；第五轮异常参数可能触发更慢的 SDF 重建 | — |

---

## 第一轮：结构性错误

1. **后壳读不到前壳参数（原工程 bug）**
   - 原因：前壳把「锁类型 / 前后基准值 / 锁深度」写入命名属性 `锁与前后` 时用的是 INSTANCE 域。开启布尔后输出里已经没有实例，属性随之丢失，后壳读到的是 (0, 0, 0)，切分位置和锁结构因此与前壳对不上。
   - 修复：前壳的「存储已命名属性」改为 **POINT 域**；后壳的「属性统计」也改为 POINT 域并取 **Max**。不取平均值，是为了避免浮点误差把锁类型 1 截断成 0。
2. **后壳连接件和垫片穿出外表面（原工程 bug）**
   - 原因：前壳先对 `头壳低面封闭` 做「表面细分」再用作头壳实体，后壳漏了这一步，直接用低模外笼求交。低模外笼比真实外表面大约 2.5 mm。
   - 修复：后壳补上「表面细分」，与前壳结构一致。
3. **缩放未应用**
   - 原因：两棵节点树都以 ORIGINAL 空间读取 `头壳低面封闭`，会忽略物体缩放。捏脸后如果没有应用缩放，壳体与头壳会差 4%～7%。
   - 修复：对头壳、头壳低面封闭、视孔、耳朵、睫毛系、立方体、视孔备用应用缩放，并重新绑定睫毛的表面形变。
4. 后壳的 `切换` 节点重新接回「是否布尔」输入（Input_18）。
5. 清理了不属于任何集合的重复对象和重复节点组，所有引用都指回场景中的真实对象。
6. 锁深度位移按演示视频改为 1.100（原文件为 1.04）。

## 第二轮：打洞与表面质量

1. **后壳打洞没有穿透**：`后壳打洞` 里共 33 个棱柱（镜像后 66 个）。保持原作者的钻孔方向和截面不变，沿各自轴线把两端延伸到外表面外 8 mm、内表面内 8 mm，保证完全贯穿。
2. **表面细分**：前后壳都改为 Level 3，并开启 Limit Surface。
3. **共面闪烁（z-fighting）**：新增 `头壳实体内缩` 节点，把头壳实体沿法线向内缩 0.15 mm，**只用来裁剪附件**（连接件、锁、垫片、中缝块、耳根）。这样附件的外表面藏进主壳壁里，两者仍有体积重叠，所以打印出来是一体的。共面面积从约 25 cm² 降到 3.8 cm²，剩下的部分都在中缝切面上，外面看不到。
4. **着色与微裂缝**：输出前依次加上面平滑、按 30° 角度设锐边、按距离合并 0.05 mm（`焊接微裂缝`），退化面全部清除。
5. 关闭视口 Workbench 的 Shadow。斜向长条状的「阴影」是视口渲染的伪影，不是几何问题。

## 第三轮：结构强度与风扇口

1. **孔周强度**：把每个孔的轮廓向外扩 4 mm 后检查，要求扩大后的轮廓仍完整落在后壳壳壁上，并且离连接件、锁等结构至少 4 mm。不满足要求的 3 个菱形孔（镜像共 6 个）已删除。
2. **风扇口（四叶草）**：原位置有一瓣约 40% 落在前壳上。现在把四叶草整体绕竖轴向后旋转 11°，新中心为 (±9.8, −0.2, 11.1) cm，外接半径 23.8 mm，轮廓外扩 5 mm 后仍完全落在后壳上。与风扇区冲突的 1 个菱形孔（镜像共 2 个）已删除。
3. 前壳不打任何孔。

## 第四轮：性能、法线与参数

1. **布尔求解器改为 Manifold**：全部 18 个网格布尔节点从 EXACT 改为 Manifold，开启布尔后前后壳重算从约 3 分钟降到约 2 秒。与 EXACT 结果逐点对比，前壳最大偏差 0.09 mm，后壳 0.02 mm。Manifold 只接受封闭网格，因此一并修了下面几处输入：
   - **嘴部重复填充（原工程 bug）**：闭嘴时上下唇已被「焊接」修改器合上，`补洞` 仍按「张嘴」顶点组再盖一块面，导致 `头壳低面封闭` 出现 1 条开放边和 6 条三面共用的边。现在嘴部只沿真正的开放边填充，闭嘴时自动不填。
   - **`小锁结构` 网格（原工程 bug）**：补上 1 个三角形小洞，删除 1 条游离边。
   - **`锁` 的镜像锁切割体**：以 −1 缩放实例化，法线朝内。现在先实现实例再翻转面。
   - **空锁保护**：锁类型 2（不加锁）时锁结构为空。Manifold 求交会跳过空输入、返回整块头壳实体，因此 `锁` 和前后壳的 `网格布尔.003` 在锁结构为空时直接输出空几何。
2. **法线方向（原工程 bug）**：
   - `实体文字.001` / `实体文字.002` 把挤出前的底面直接并回，没有翻转，每个字的底面朝内。现在加了「翻转面」。
   - 用 −1 缩放镜像的部件没有翻转法线，整块里朝外：后壳右侧插扣两件、前后壳文字。现在镜像后都加了「翻转面」。
   - 结果：前后壳全部部件法线一致朝外，第三轮遗留的「前壳耳侧锁盒 9 条法线不一致的边」一并消失。
3. **刻字字体**：前后壳文字原来引用的字体路径不存在、也没有打包，文字实际上一直没有生成。现在前后壳和眼线文字统一改用 **HarmonyOS Sans SC Bold**，并打包进 `.blend`；删除两个阿里巴巴普惠体数据块。
4. **前后基准值限制在 0～0.85**：这个值是分界线在头顶曲线上的位置比例（有效范围 0～1）。超过约 0.93 时，风扇口最靠前的一瓣会落到前壳上而切不完整；超过 0.855 时离分界线不足 5 mm。现在接口范围和节点内部都限制在 0～0.85。
5. **后壳圆角位置重新定义（原工程 bug）**：原实现把 `后壳布尔` 的圆弧顶点连同底部两个角点一起平移，取 0 时仍有约 0.19 cm³ 的缺口，取负值时缺口还没完全合上，后壳就已经压进前壳（−0.1 时重叠 0.26 cm³）。现在：
   - 后壳主体再减去前壳的切割范围，后壳在任何取值下都不会与前壳重叠；
   - 0 = 无缺口，数值越大缺口越大，不再接受负值；原来的 0.017 对应现在的 **0.037**（形状偏差 ≤ 0.05 mm）。
6. **导出 STL 的拓扑**：原来各部件（壳体、耳朵、插扣、锁、文字）只是简单合并，再用 0.05 mm 的「焊接微裂缝」做距离合并，会把相邻部件上靠得很近的顶点焊在一起，导出的 STL 有上百条开放边和非流形边。现在：
   - 每个壳的全部部件用 Manifold 做**布尔并集**（`部件并集`），删除「合并几何」和「焊接微裂缝」；
   - 后壳插扣的底座（`网格布尔.005`）和舌片（`网格布尔.006`）先单独并集（`插扣并集`），否则重叠的两块会被当成一个自相交的输入，舌片熔不进去；
   - 并集后先用 Beauty 方式三角化（`输出三角化`），避免导出器把凹多边形三角化成重叠的三角形；再只沿边合并 0.01 mm 以内的微小边（`清理微小边`，「已连接」模式）。先合并再三角化时，个别几乎自接触的多边形会三角化出开放边；
   - 最后删除布尔偶尔留下的「碎片面」：挂在开放边上、面积小于 0.1 mm² 的面（`清除碎片面_1`～`_3`）。封闭网格没有开放边，这一步不会动到正常的面；
   - `实体文字` 的合并距离从 0.1 mm 改为 0.001 mm，字形保持封闭。
   - 结果：后壳是一整块实体；按默认参数导出的 STL，前后壳都是 0 条开放边 / 0 条非流形边 / 0 个退化三角形。修改前分别是上百条。
7. **曲面加密**：原工程的曲面都是低段数多边形，切片软件里能看到明显的棱面。
   - 铰链：`前壳连接件`、`后壳连接件` 的关节外圆柱（R 7.23 mm）、销轴孔（R 2.85 mm）和端部倒角圆锥从 32 段加密到 128 段，新顶点投影到拟合出的真实圆柱 / 圆锥面上（拟合残差 ≤ 0.02 mm）。
   - 其余曲面：连接件、`前壳布尔` / `后壳布尔`（铰链中段弧面）、`插扣`、大小锁结构及其切割体、`后壳打洞`（通风孔孔壁）。凡是一串相邻边以 4°～50° 的小角度连续转折的地方，都按圆弧处理：每条边切成 4 段，新顶点放在过相邻顶点、并在原顶点处切线连续的圆弧上；双向弯曲的圆角区域内部按 Coons 曲面插值。原顶点一律不动，所以平面、直边和锐边保持原样。单段倒角（两侧都是长直边）视为设计，不做圆化。
   - 新顶点离原棱面最多 0.56 mm（大多数在 0.1 mm 以内）。为避免改变配合关系：
     - 前后壳切割体在分界线上重合的边不加密，前后壳的接缝保持原样；
     - `后壳布尔` 中受「圆角位置」驱动的顶点组边界不加密；
     - 锁结构与锁切割体按同一规则加密，1.5 mm 的设计间隙保持不变。
8. **前壳铰链关节被削平**：前壳两个关节的外圆柱（R 7.23 mm）在端部比头壳实体内缩面高出约 0.49 mm，被裁剪附件的步骤削掉一块，顶部和端部倒角处出现透镜状的平面。现在关节外圆柱半径减小 0.56 mm（R 6.67 mm），整段都落在裁剪面以内，保持完整的圆柱；销轴孔（R 2.85 mm）和端部倒角终点不变，关节壁厚从 4.38 mm 变为 3.82 mm。后壳关节埋在后壳连接件的顶板下，没有这个问题。前壳最高点原来就是被削平的关节顶面，所以前壳高度减少 0.55 mm。

## 第五轮：Blender 5.2.2 导出回归与视孔生成

修改日期：2026-10-21。修复脚本为 `tools/repair_model.py`，基线是提交 `d26e53d`。

1. **默认后壳的悬挂面**
   - 默认 `锁类型=1 / 前后基准值=0.78 / 圆角位置=0.037` 下，实际 STL 中仍有 2 条开放边和 1 条三面共边。问题位于 +X 侧锁结构，约 `(100.10, -29.50, 29.48) mm`。
   - 残留三角面面积约 0.165 mm²，超过第四轮面积阈值 0.1 mm²。新增共享节点组 `Pulsar 输出拓扑清理`：识别同时含开放边和多面共边、面积小于 10 mm² 的悬挂面，最多剥离 8 次；清除表面积小于 1 mm² 且不足 20 个面的碎片孤岛，再清除游离边与孤立顶点。
   - 清理不会把整个网格按距离合并；原有正常顶点保持原位，耳内封闭空腔保留。
2. **大圆角和极端分界参数的输出**
   - `圆角位置=0.1` 时，单纯删掉悬挂面仍会留下插扣附近的零厚度接触、碎片和重合边。`前后基准值=0` 的部分组合还会在 float32 毫米坐标下产生退化三角形，即使每条边恰好关联两个面。
   - 清理后检查边面数，并把一份诊断几何变换到世界坐标和毫米尺度，检查最小三角面面积。存在非双面边或面积不大于 `1e-12 mm²` 的面时，才启用 SDF 重建分支。
   - 重建使用已经明确三角化的表面，避免原始凹多边形被再次以不同方式三角化。参数为 0.1 mm 体素、3 体素带宽、零等值面和 0.1 自适应度；重建后再三角化、仅沿连接边焊接 1 μm 内顶点，并执行同一拓扑清理。
   - 默认参数不触发重建。大圆角重建后网格明显更密，计算也更慢。0.1 mm 是采样尺寸，不是所有点的最大误差承诺。
   - `锁类型=1 / 前后基准值=0.78 / 圆角位置=0.1` 的逐顶点距离检查中，新表面到修复前表面的最大距离约 0.105 mm，99% 在 0.043 mm 内。反向距离较大点集中于被清除的薄片和退化结构；不能把正向距离当作双向 Hausdorff 上界。
3. **视孔生成为空**
   - 原节点从布尔结果读取 `sharp_face` 筛选来源面，但 5.2.2 的当前结果中没有这个属性，筛选后整个视孔为空。更换 Exact 求解器也不能恢复。
   - 布尔之前在头壳面域显式写入 `pulsar_vision_surface` 布尔属性，布尔之后按此属性筛选。替换多输入连接时明确移除旧连接，避免重复求交同一个头壳。
   - 「反向」改用来源面的 Y 法线方向区分内外面，保持默认内侧、反向外侧的行为，避免依赖布尔后不稳定的孤岛序号。
4. **眼线实际 STL 的重复三角形**
   - 求值网格的边邻接检查曾通过，但真实毫米坐标检查发现布尔输出有 18 个重复三角形，开启刻字后有 2 个。
   - `眼线配置` 输出增加显式三角化、仅沿连接边的 0.01 mm 焊接和共享拓扑清理。
5. **闭嘴时的空填洞输入**
   - 嘴部开放边不足 3 个顶点时跳过填充节点组，避免空输入触发 `Vertices must be at least 3` 警告；保留张嘴时的填洞路径。
6. **可重复验证**
   - 新增 `tools/validate_model.py`，检查 float32 毫米坐标下的开放边、多面共边、面绕序、重复和退化三角形，同时检查工程中的游离边与孤立顶点。
   - `--matrix` 覆盖锁类型 0/1/2、前后基准值 0/0.3/0.65/0.78/0.85、圆角位置 0/0.037/0.1 的 45 组组合；另有默认、大圆角实际导出、视孔正反向与瞳距 5.5/6.03/7.0、眼线布尔和刻字，并补充三种睫毛在睁眼大小 0/0.3 时的检查，共 61 个场景。
   - 近零面积与退化分开记录：小于 `1e-8 mm²` 记为近零面积，不大于 `1e-12 mm²` 判为退化。仅通过边邻接或仅用 Blender 顶点编号检查，均不足以替代导出验证。
   - 结果：最终 61/61 场景通过，默认和大圆角的四个实际 STL 均通过；原始数据保存在 `docs/validation-2026-10-21.json` 和 `docs/surface-comparison-2026-10-21.json`，以文件 SHA-256 标识被检版本。
7. **三种睫毛分别绑定形变**
   - 原来在样式选择之后统一执行 Surface Deform，绑定数据固定为 97 个顶点。切到 76 或 86 顶点的类型 1/2 时会出现 `Vertices changed` 警告，形变不能按预期工作。
   - 将默认绑定移到隐藏的 `睫毛0_形变源`，与原对象共享基础网格；给 `睫毛1`、`睫毛2` 分别绑定到 `睫毛形变`，在样式选择之前完成各自的形变，随后统一细分、镜像和平滑。
   - 默认样式的求值顶点逐位一致；另两种样式的初始姿态差异小于 0.00004 mm。三种样式均能随睁眼大小 0 → 0.3 移动，睫毛和眼线输出的六组检查全部通过。详见 `docs/eyelash-validation-2026-10-21.json`。
8. **参数界面说明**
   - 锁类型的界面范围补齐为 0～2，并标明大小锁与无锁的映射；睫毛类型限制为实际存在的 0～2。
   - 移除视孔「检查头壳平直着色」的过时提示，说明生成、反向和瞳距的作用。
   - 界面调整前后，8 组锁、睫毛和视孔配置的网格摘要一致，记录见 `docs/parameter-help-verification-2026-10-21.json`。

## 打印交付：隐藏睫毛并分别导出 STL

修改日期：2026-10-21。

- 按用户确认，仅隐藏黑色 `睫毛` 和 `眼线配置` 的视口／渲染显示，保留眉形开孔及全部节点引用。
- 隐藏前后两壳的求值顶点与三角面指纹完全一致；保存后重新打开，确认隐藏状态并检查当前配置。
- 分别导出毫米坐标的 `ProjectPulsar_Front.stl` 和 `ProjectPulsar_Rear.stl`，实际回读拓扑通过；三角形载荷与第五轮完整回归时的默认 STL 逐字节一致。
- `docs/stl-export-manifest-2026-10-21.json` 记录导出文件哈希、尺寸及检查结果。STL 保存在本地 `exports/2026-10-21/`，作为可重新生成的产物忽略，不写入 Git。
- 使用手册补充设备空间、分件、壁厚、支撑、公差试片以及树脂耳内空腔的处理建议。打印机与材料尚未指定，没有生成机器专用 G-code，也没有新增实物打印验收结论。

## 独立插销补充导出

修改日期：2026-10-21。

- 小锁锁座与后壳侧边插扣已包含在前后壳输出中；`锁结构` 集合里的独立 `r插销` 未被两壳节点引用，需单独导出。
- 原插销按毫米 STL 坐标检查有 2 条开放边、1 条多面共边和 2 个退化三角形。以 0.00001 mm 合并重合点，清除退化边，明确三角化并重算法线后，三角面数由 1,028 减为 1,026，上述缺陷均为 0。
- 修复前后唯一顶点位置及包围盒尺寸一致。三角化使非平面多边形的插值方式明确，材料体积从约 0.617902 cm³ 变为 0.617931 cm³；未声称全部三角面表面逐位一致。
- 已补充 `ProjectPulsar_R_Pin.stl`。两壳顶点与三角面指纹一致，重新打开保存的工程再导出，三个 STL 的三角形载荷与交付文件一致。证据见 `docs/lock-pin-validation-2026-10-21.json`。
- 可重放脚本为 `tools/repair_lock_pin.py`。只修改独立插销，不更改锁类型、锁座或其他辅助源对象。尚未进行实物装配与疲劳测试。
- 随后确认打印方案为 H2S / 0.4 mm / PLA，按官方 340 × 320 × 340 mm 空间核算，两壳各自含每侧 8 mm brim 余量仍可放入。使用手册增加对应工艺、耗材预设及插销摆放建议；只完成配置核对与包围盒核算，未进行设备切片。

## 闭合结构说明更正

检查日期：2026-10-21。本次只修改文档与检查配图，不改动 `.blend` 或 STL。

- 补充侧边锁座外侧与顶部铰链的真实局部视图。侧边固定特征与壳体并为一体，不能作为已装配的活动锁具。
- 更正将独立 `r插销` 导出描述成“锁扣补齐”的过度表述。该对象没有原始装配定位，也未验证其与侧锁或顶部铰链的配合，具体用途、数量及操作方向仍待确认。
- 拟合得到前壳铰链孔口圆弧直径约 5.70 mm，沿拟合轴线可穿过前后壳；此测量不等于完整插销的插入和止退验收。
- 手册分别标明确定的几何事实、按外形作出的推断和未确认的装配项目。保留已验证的网格／STL 结果，避免将其扩展为机械功能验收结论。

## 侧锁尺寸与商品比对

检查日期：2026-10-21。本次只更新测量记录、尺寸图及手册，不改动源模型或 STL。

- 将当前锁结构按五组匹配圆特征还原至自身长宽方向，测得平直安装段轮廓约 45.78 × 30.77 mm、完整槽轮廓约 59.25 × 30.77 mm。定位柱长向两排间距约 19.42 mm，横向分别约 20.01 / 20.71 mm。
- 明确四处为约 Ø2.81 mm 的实心柱，并非已打好的螺丝孔；热铆为按形状推断的可选方案，螺丝固定需要重新设计孔与承力座。
- 根据用户新提供的带锁款尺寸图，40 × 27 mm、20 × 20 mm 孔距、Ø3.5 mm 孔的带锁款比先前两款无锁款更接近当前结构。保留孔位差异和未完成实物配合的说明，不将“最接近”写成“已确认直装”。

## 备份数据

`.blend` 文件内保留了两个设置了 Fake User 的网格，可以用来对照或回滚：

- `后壳打洞_原始备份`：原作者的打洞网格
- `后壳打洞_第二轮前备份`：删孔、调整风扇口之前的打洞网格

---

## 原作者的设计（不是 bug）

- 后壳插扣、垫片与前壳内侧的体积重叠：这是插接结构。
- 顶部铰链处的矩形缺口：这是铰链的转动槽。

## 第四轮遗留记录

- 导出的 STL 在个别参数组合下仍可能剩几条开放边：实测 9 组参数（锁类型 0/1/2、前后基准值 0.3～0.85、圆角位置 0～0.1）中 8 组前后壳全部为 0，只有「前后基准值 0.65 + 圆角位置 0」的后壳剩 2 条开放边 / 1 条非流形边，都在小于 0.1 mm 的点上，切片软件的「修复」可以直接处理。
- 耳朵是封闭网格经实体化得到的空心耳朵，内部有封闭空腔（前壳每侧 2 个），会被识别为独立的内部壳，打印时就是空心耳朵。原工程即如此。
- 眼线刻字和视孔生成两个功能默认关闭，换成 Manifold 求解器后尚未单独验证。
- 通风孔从 66 个减少到 58 个。如果散热不够，可以在后壳中部的空白区域补孔，补孔时按第三轮的孔周强度规则检查位置。

第五轮已重新检查上述拓扑、视孔与眼线问题，当前使用说明和验证命令以 README 为准。耳内空腔和 58 个通风孔的设计保留。数字网格验证不代表最小壁厚、材料强度、铰链运动、实物装配或佩戴散热已经验收；主体的 2.62 mm 实体化设定也不等于全域最小壁厚。
