suisanka/Project_Pulsar/(commit log)

2026-10-20 fix(model): repair generated topology and STL exports
    [ProjectPulsar_Base.blend]
2026-10-20 fix(model): stabilize eyelash variants and parameter controls
    [ProjectPulsar_Base.blend]
2026-10-20 feat(print): hide eyelashes and document STL delivery
    [ProjectPulsar_Base.blend]
2026-10-20 fix(print): repair and export the independent lock pin
    [ProjectPulsar_Base.blend]
2026-10-20 docs(print): add H2S 0.4 mm PLA setup guidance
2026-10-20 docs(model): clarify closure parts and unverified pin assembly
2026-10-20 docs(model): measure side latch mounts and compare fastening options
2026-10-20 fix(model): add retained hinge axle and bolted side latch mounts
    [ProjectPulsar_Base.blend]
2026-10-20 docs(model): add closure BOM assembly guide and print files
2026-10-21 fix(model): restore solid backing beneath side latches
    [ProjectPulsar_Base.blend]
2026-10-21 docs(bom): export v4 assembly materials as CSV
    [ProjectPulsar_BOM_Closure_v4.csv]
2026-10-22 feat(model): add measured headform fit study
    [ProjectPulsar_HeadformFit_230-135-590.blend]
2026-10-22 feat(model): export front shell with 3 mm nominal thickness
    [ProjectPulsar_Front3mm.blend]
2026-10-24 feat(model): improve rear shell clearance from reference models
    [ProjectPulsar_ReferenceFit.blend]
2026-10-24 fix(model): adopt supplied rear shell without deformation
    [ProjectPulsar_ReferenceRearExact.blend, 后半头壳-全头.stl]
2026-10-24 revert: restore Front3mm baseline before reference experiments
    [ProjectPulsar_ReferenceFit.blend, ProjectPulsar_ReferenceRearExact.blend, 后半头壳-全头.stl]
2026-10-24 revert: restore reference rear snapshot dbc034d
    [ProjectPulsar_ReferenceFit.blend, ProjectPulsar_ReferenceRearExact.blend, 后半头壳-全头.stl]
2026-10-24 feat(model): fit rounded rear to original shell interfaces
    [ProjectPulsar_ReferenceRearRounded.blend]
